freesiagaul/Dalek/Photos/Aaron General/IMG_8128.JPG

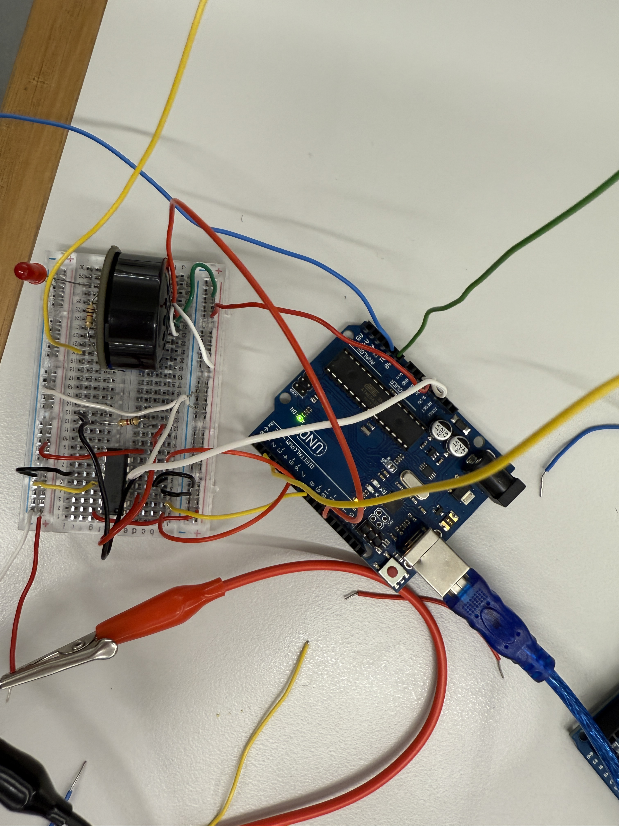
Photos/Aaron General/IMG_8128.JPG
