freesiagaul/Dalek/Photos/Aaron Camera Video/IMG_9345.JPG

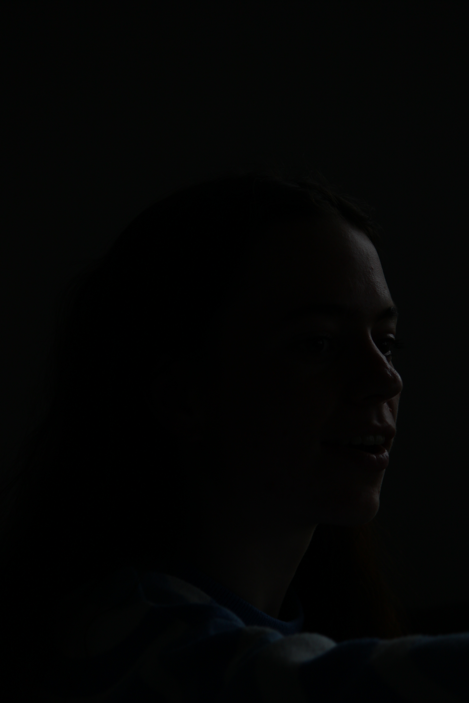
Photos/Aaron Camera Video/IMG_9345.JPG
