freesiagaul/Dalek/Photos/Aaron Camera Video/IMG_9346.JPG

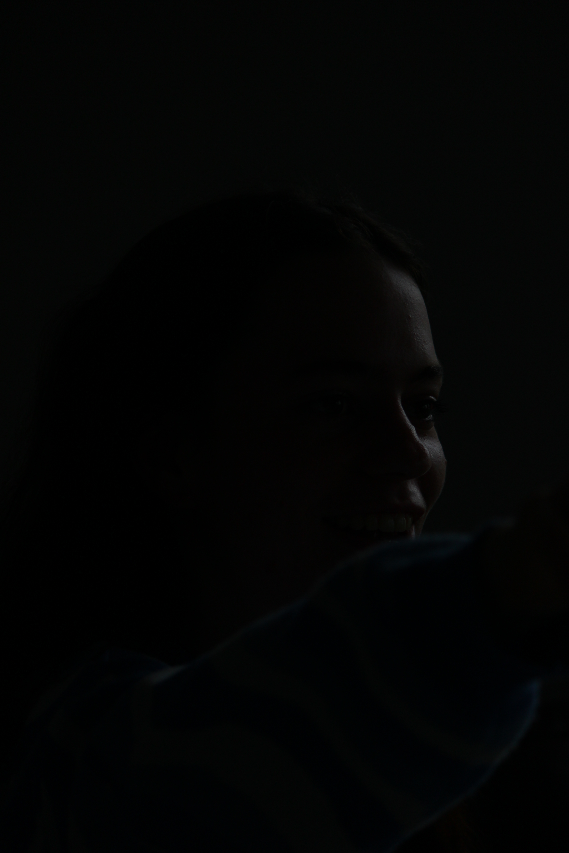
Photos/Aaron Camera Video/IMG_9346.JPG
