freesiagaul/Dalek/Photos/Aaron Camera Video/IMG_9349.JPG

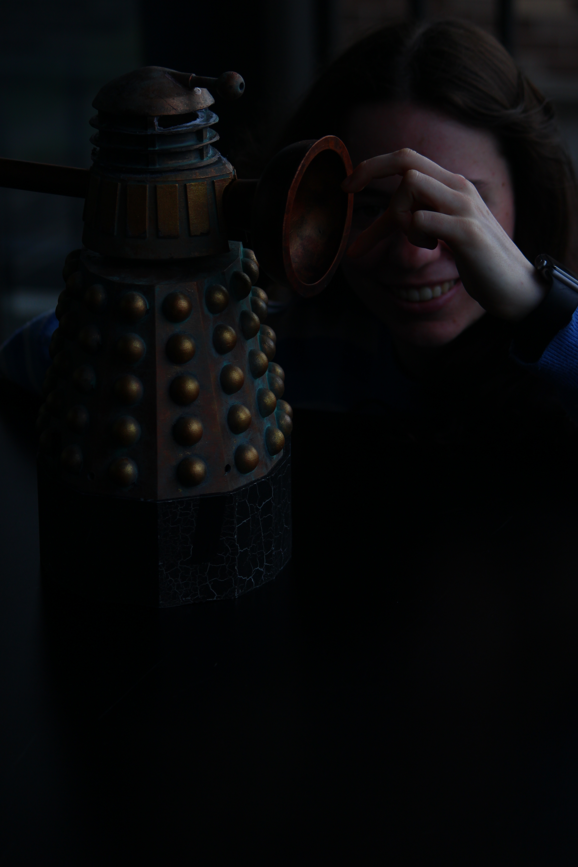
Photos/Aaron Camera Video/IMG_9349.JPG
