freesiagaul/Dalek/Photos/Aaron Camera Video/IMG_9350.JPG

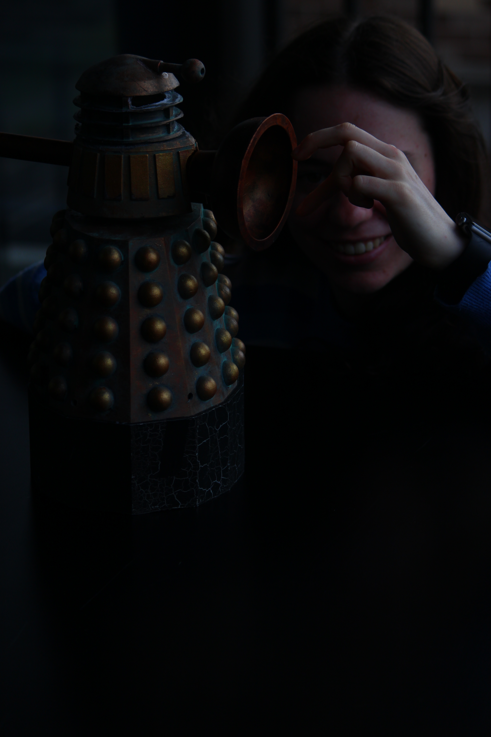
Photos/Aaron Camera Video/IMG_9350.JPG
