freesiagaul/Dalek/Photos/Aaron Camera Video/IMG_9351.JPG

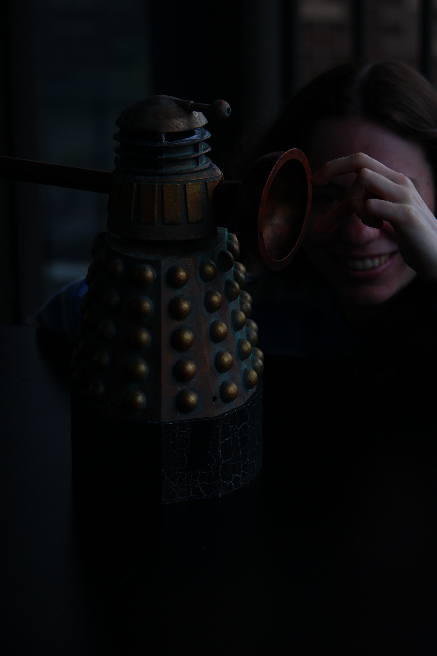
Photos/Aaron Camera Video/IMG_9351.JPG
