freesiagaul/Dalek/Photos/Aaron Camera Video/IMG_9352.JPG

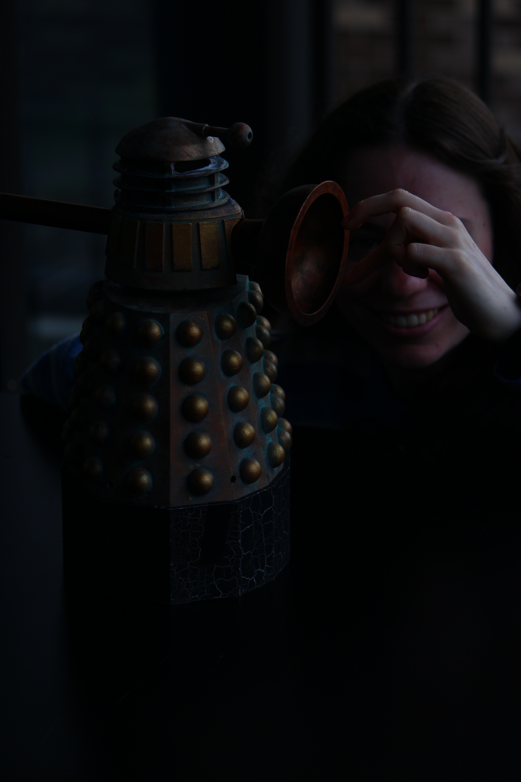
Photos/Aaron Camera Video/IMG_9352.JPG
