freesiagaul/Dalek/Photos/Aaron Camera Video/IMG_9353.JPG

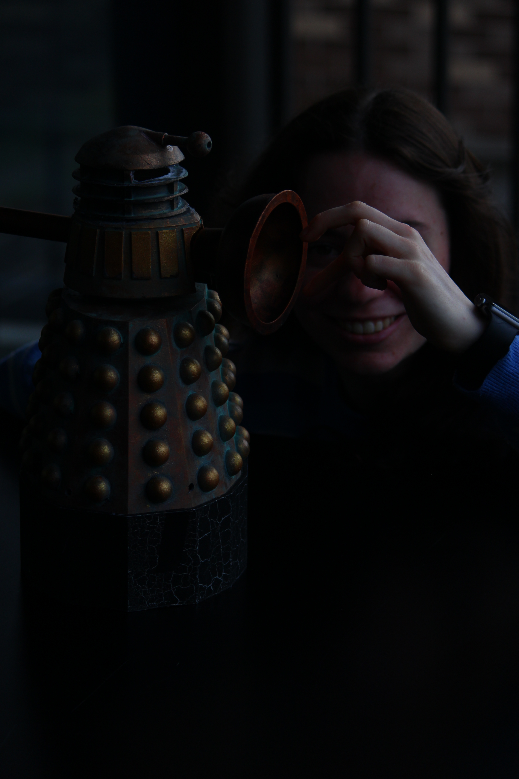
Photos/Aaron Camera Video/IMG_9353.JPG
