freesiagaul/Dalek/Photos/Aaron Camera Video/IMG_9366.JPG

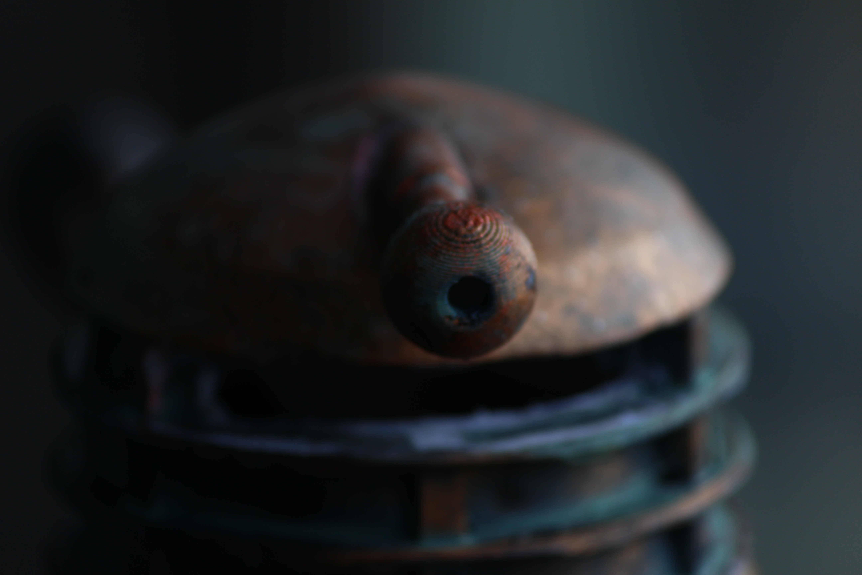
Photos/Aaron Camera Video/IMG_9366.JPG
