freesiagaul/Dalek/Photos/Aaron Camera Video/IMG_9367.JPG

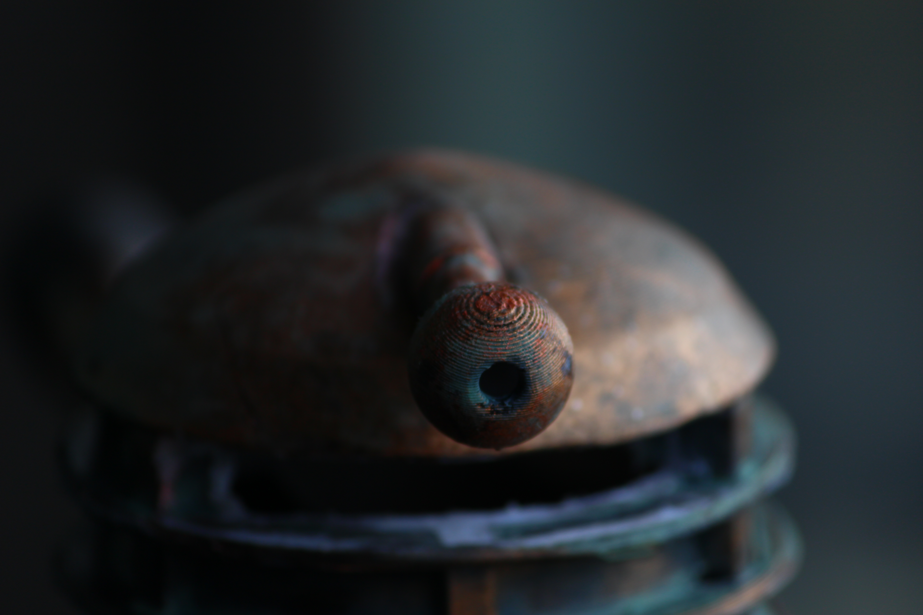
Photos/Aaron Camera Video/IMG_9367.JPG
