freesiagaul/Dalek/Photos/Aaron Camera Video/IMG_9368.JPG

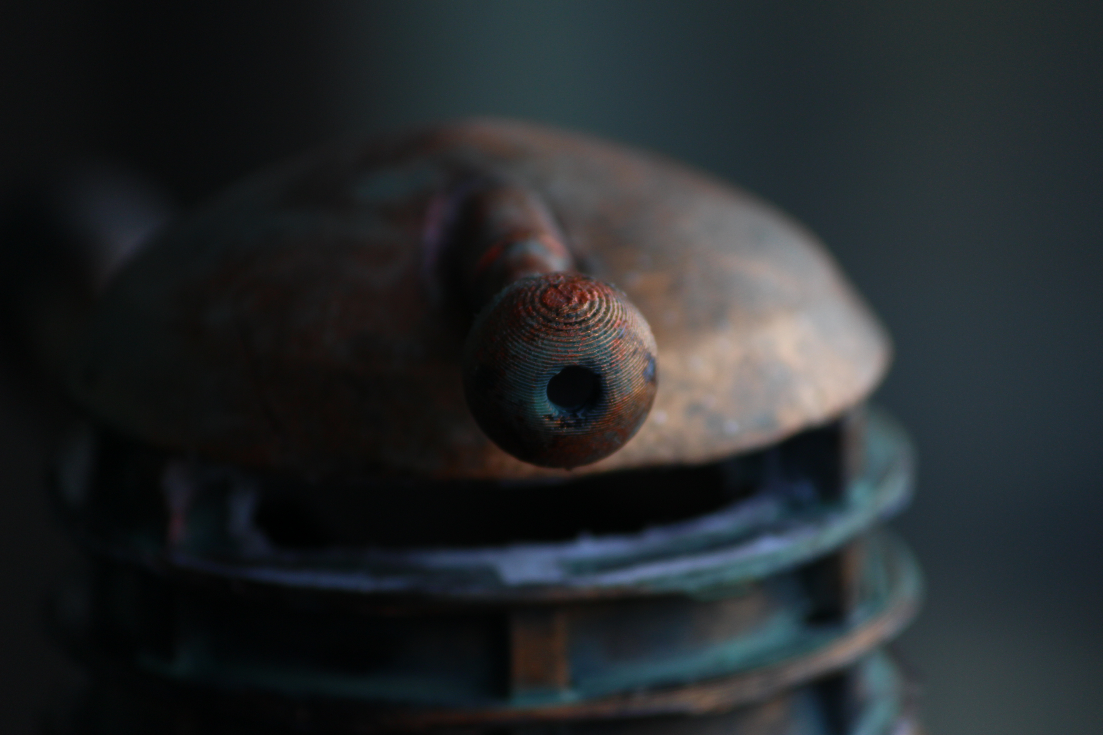
Photos/Aaron Camera Video/IMG_9368.JPG
