freesiagaul/Dalek/Photos/Aaron Camera Video/IMG_9370.JPG

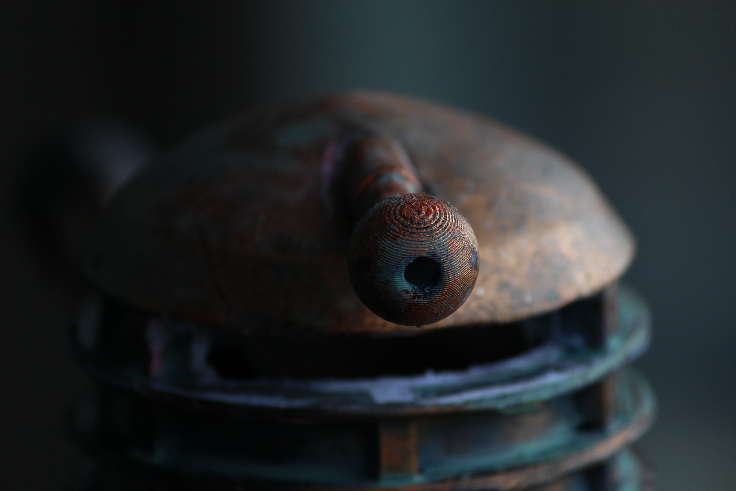
Photos/Aaron Camera Video/IMG_9370.JPG
