freesiagaul/Dalek/Photos/Aaron Camera Video/IMG_9371.JPG

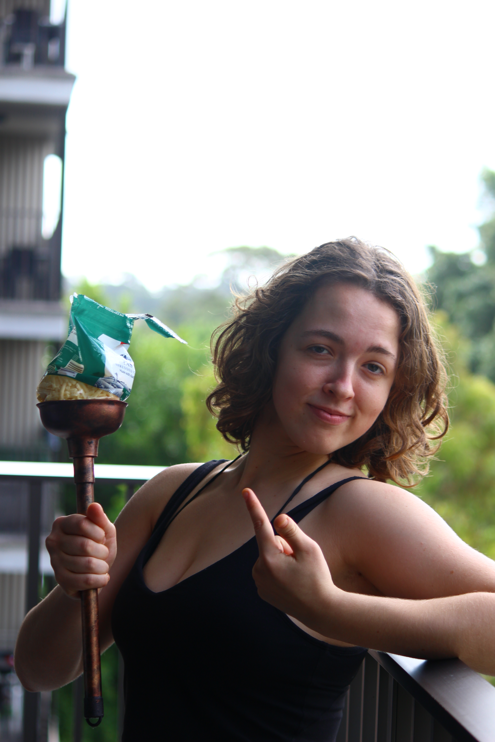
Photos/Aaron Camera Video/IMG_9371.JPG
