freesiagaul/Dalek/Photos/Aaron Camera Video/IMG_9372.JPG

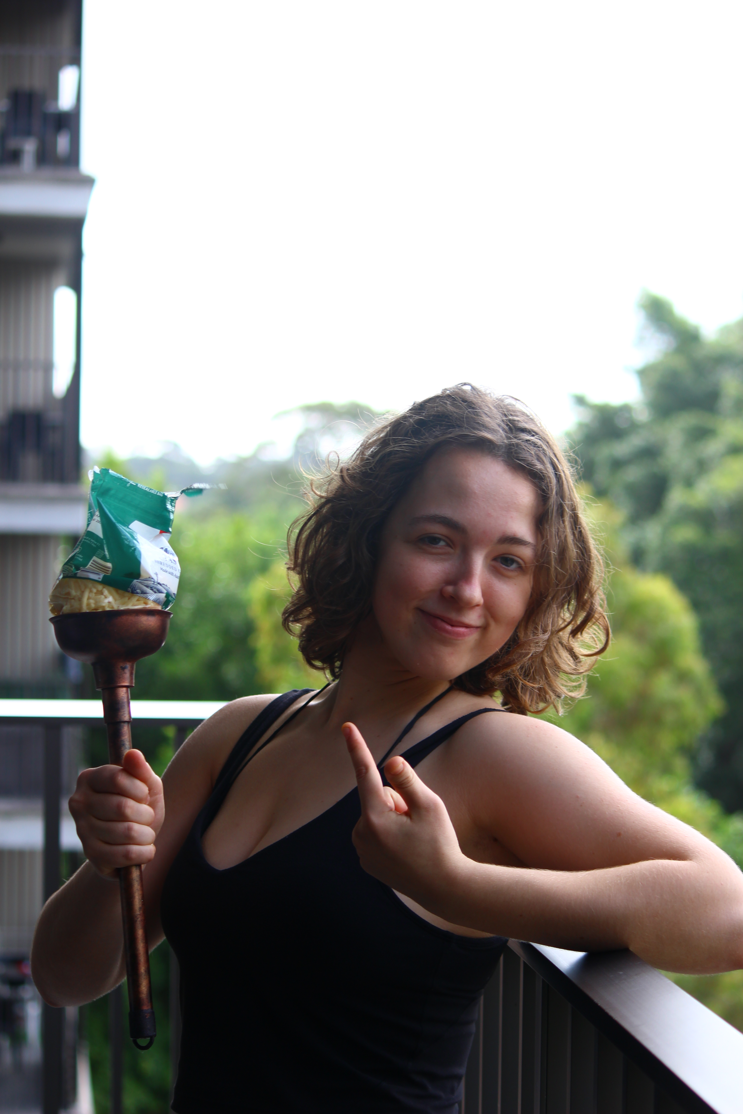
Photos/Aaron Camera Video/IMG_9372.JPG
