freesiagaul/Dalek/Photos/Aaron Camera Video/IMG_9373.JPG

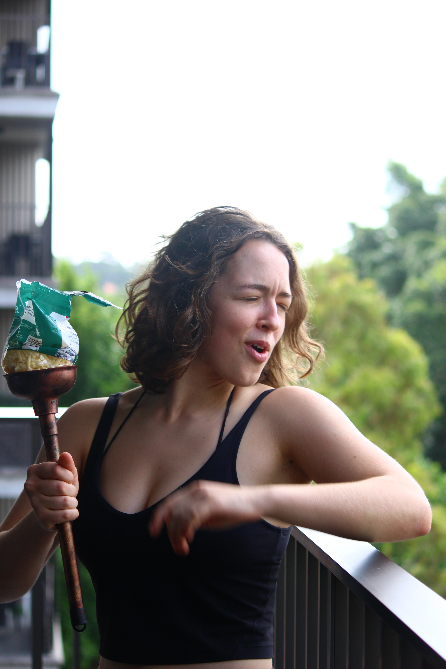
Photos/Aaron Camera Video/IMG_9373.JPG
