freesiagaul/Dalek/Photos/Aaron Camera Video/IMG_9376.JPG

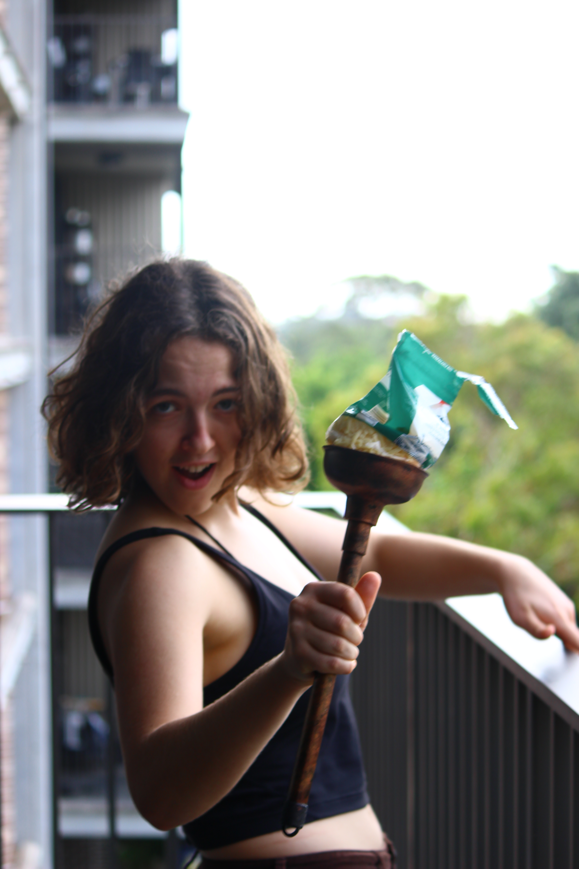
Photos/Aaron Camera Video/IMG_9376.JPG
