freesiagaul/Dalek/Photos/Aaron Camera Video/IMG_9407.JPG

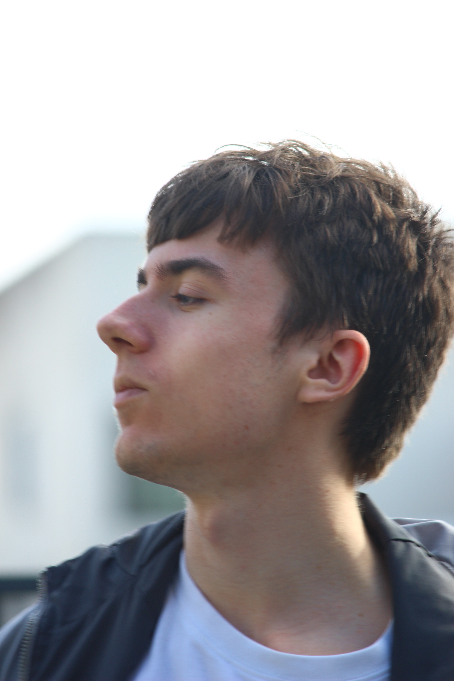
Photos/Aaron Camera Video/IMG_9407.JPG
