freesiagaul/Dalek/Photos/Aaron Camera Video/IMG_9408.JPG

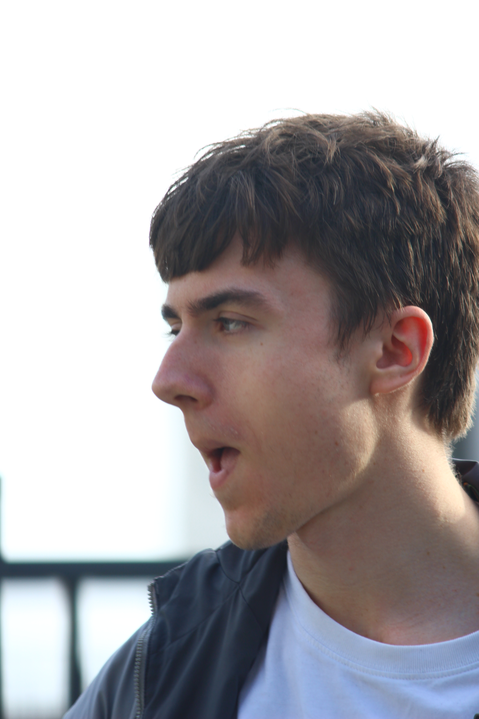
Photos/Aaron Camera Video/IMG_9408.JPG
