freesiagaul/Dalek/Photos/Aaron Camera Video/IMG_9412.JPG

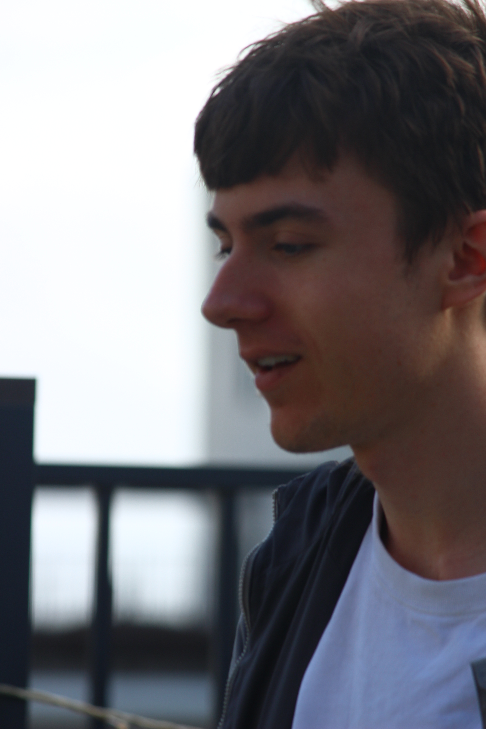
Photos/Aaron Camera Video/IMG_9412.JPG
