freesiagaul/Dalek/Photos/Aaron Camera Video/IMG_9414.JPG

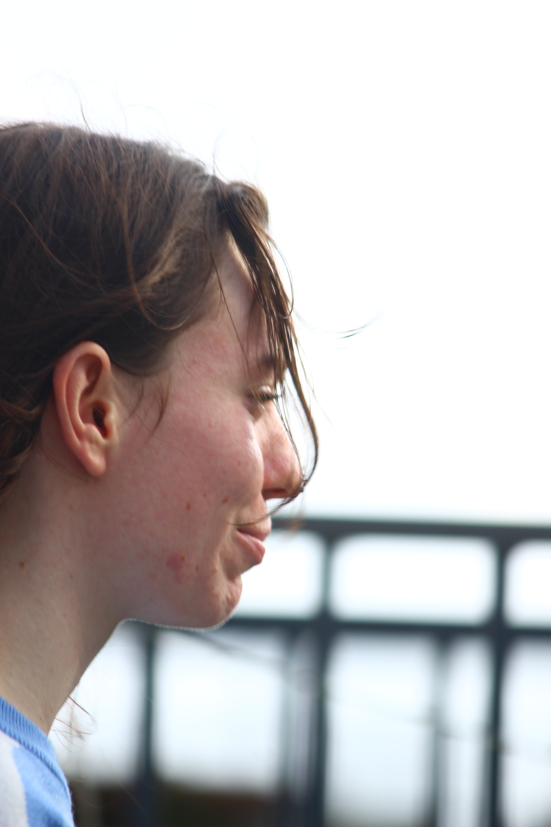
Photos/Aaron Camera Video/IMG_9414.JPG
