freesiagaul/Dalek/Photos/Aaron Camera Video/IMG_9441.JPG

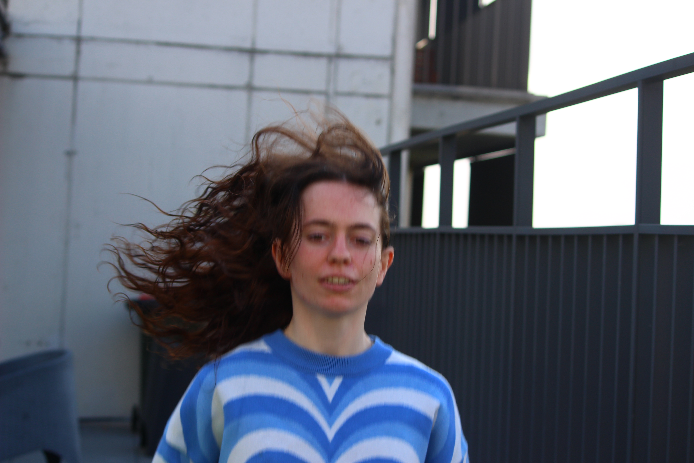
Photos/Aaron Camera Video/IMG_9441.JPG
