freesiagaul/Dalek/Photos/Aaron Camera Video/IMG_9444.JPG

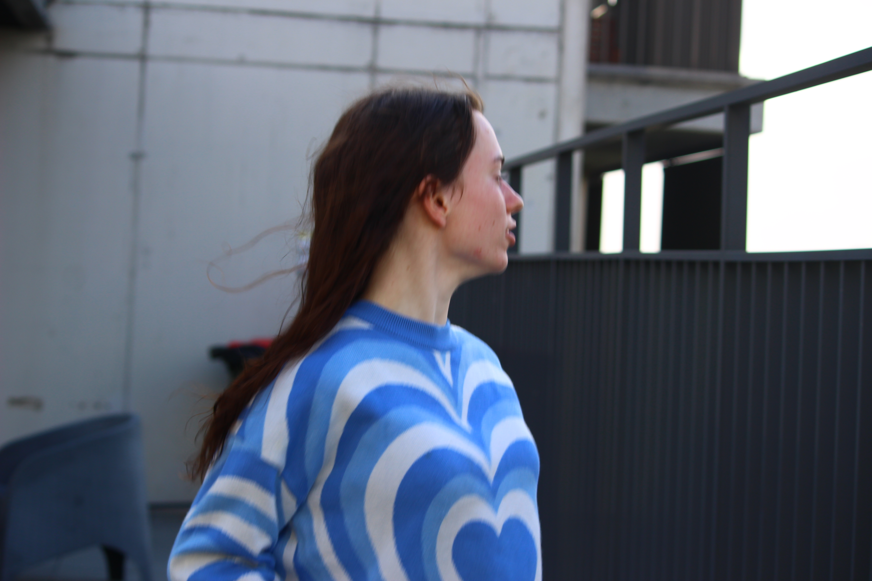
Photos/Aaron Camera Video/IMG_9444.JPG
