freesiagaul/Dalek/Photos/Aaron Camera Video/IMG_9469.JPG

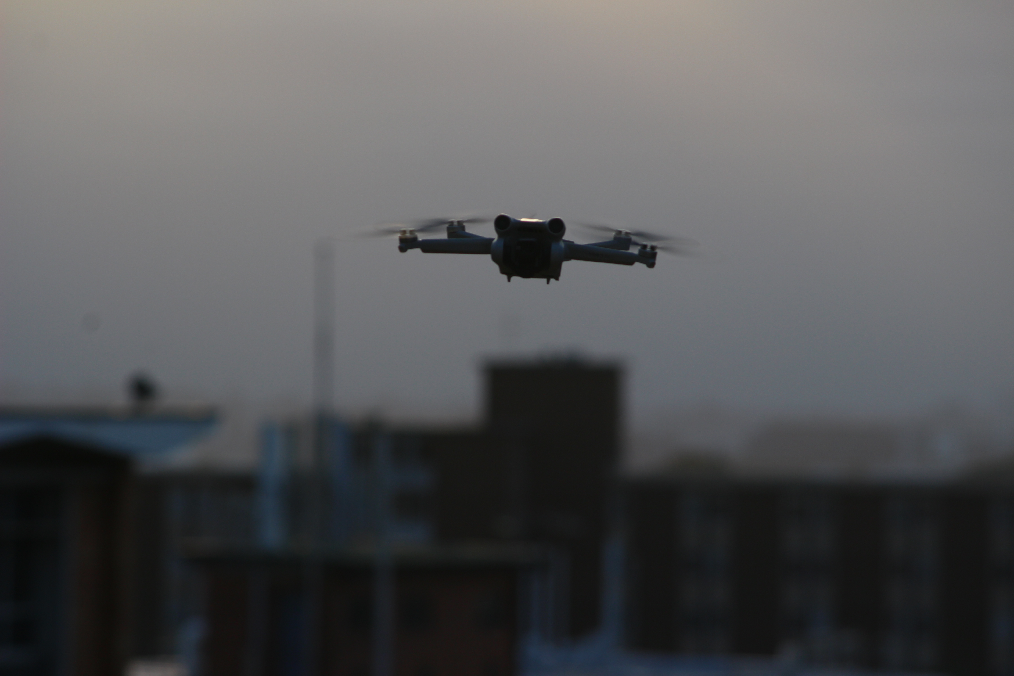
Photos/Aaron Camera Video/IMG_9469.JPG
