freesiagaul/Dalek/Photos/Aaron Camera Video/IMG_9470.JPG

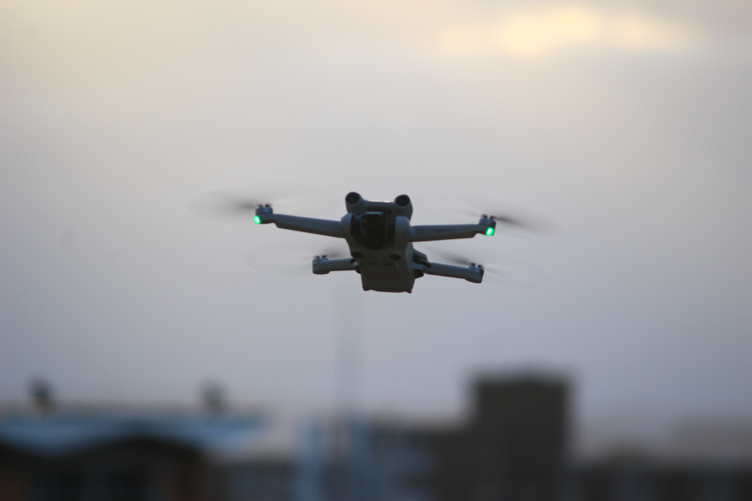
Photos/Aaron Camera Video/IMG_9470.JPG
