freesiagaul/Dalek/Photos/Aaron Camera Video/IMG_9471.JPG

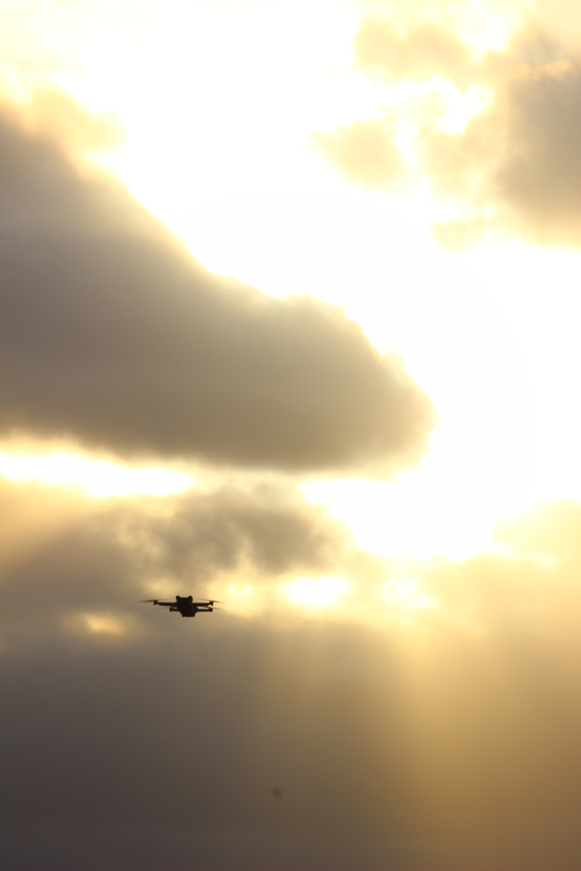
Photos/Aaron Camera Video/IMG_9471.JPG
