freesiagaul/Dalek/Photos/Aaron Camera Video/IMG_9472.JPG

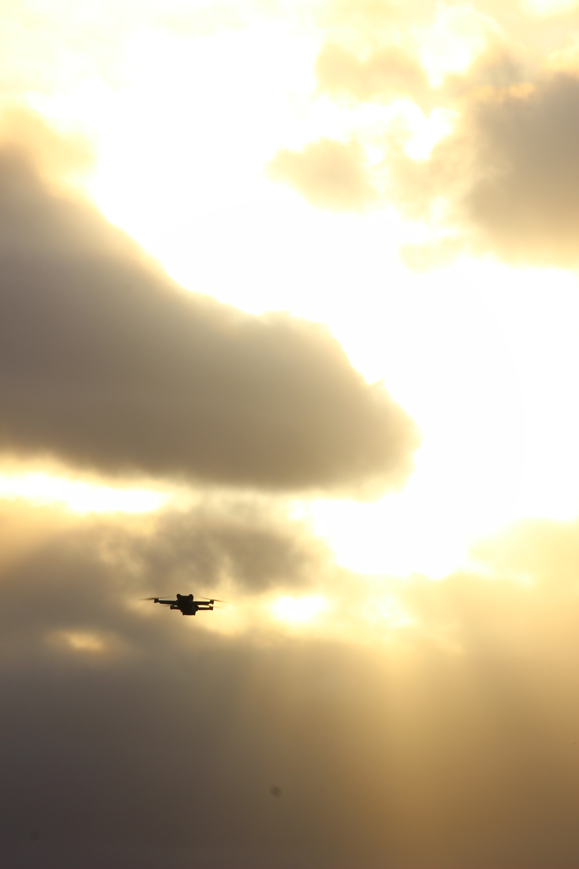
Photos/Aaron Camera Video/IMG_9472.JPG
