freesiagaul/Dalek/Photos/Aaron Camera Video/IMG_9473.JPG

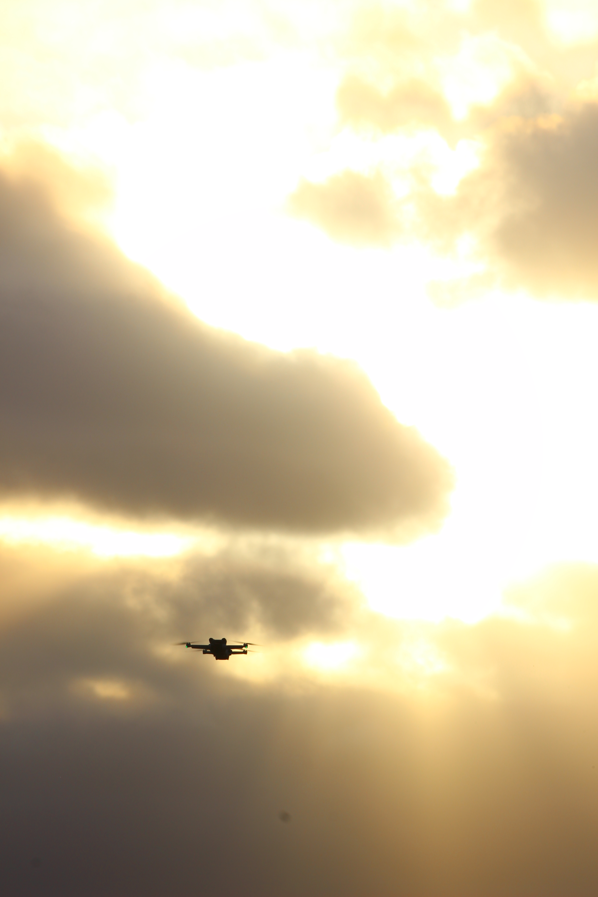
Photos/Aaron Camera Video/IMG_9473.JPG
