freesiagaul/Dalek/Photos/Aaron Camera Video/IMG_9474.JPG

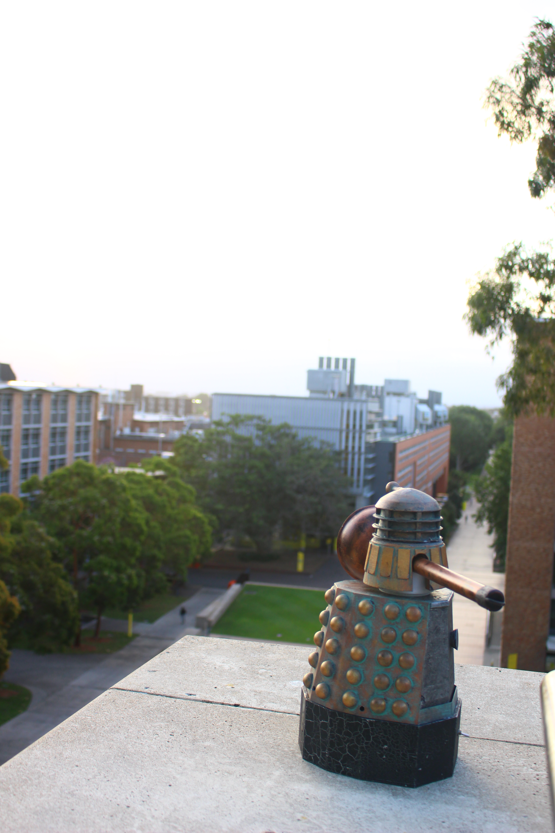
Photos/Aaron Camera Video/IMG_9474.JPG
