freesiagaul/Dalek/Photos/Aaron Camera Video/IMG_9475.JPG

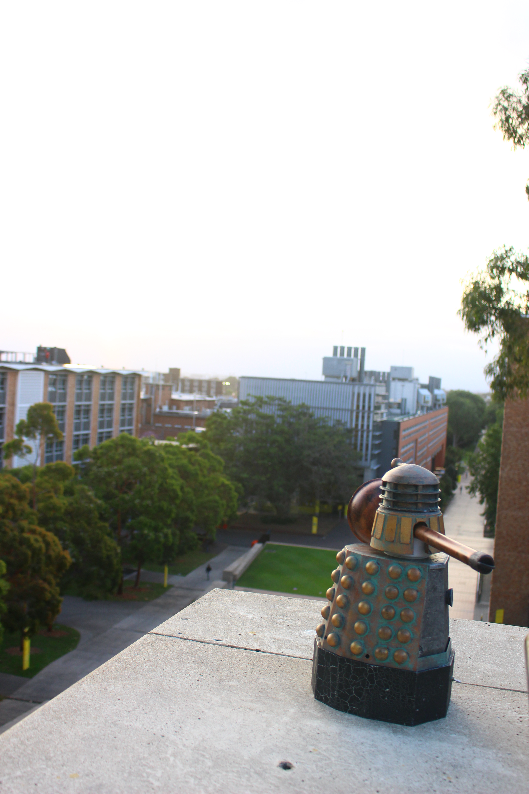
Photos/Aaron Camera Video/IMG_9475.JPG
