freesiagaul/Dalek/Photos/Aaron Camera Video/IMG_9476.JPG

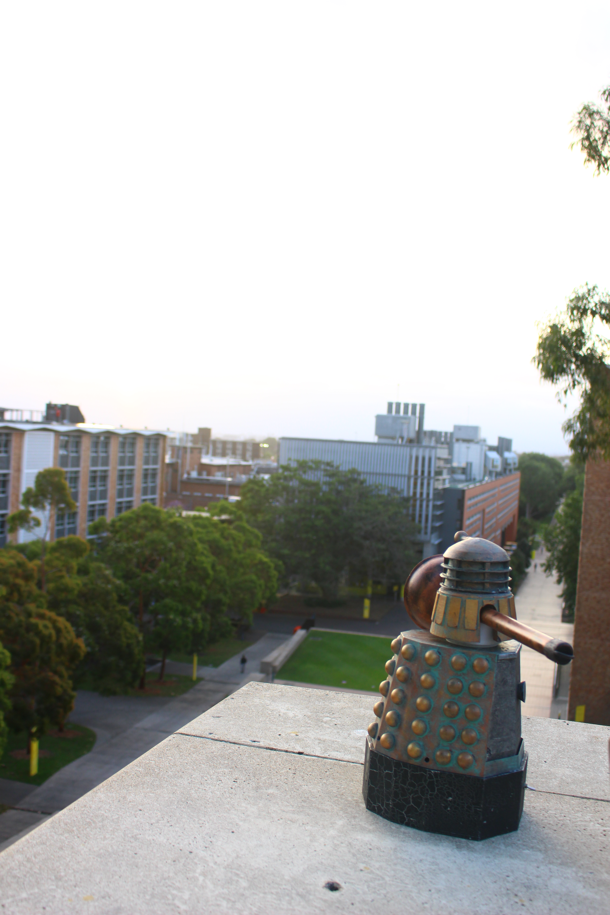
Photos/Aaron Camera Video/IMG_9476.JPG
