freesiagaul/Dalek/Photos/Aaron Camera Video/IMG_9477.JPG

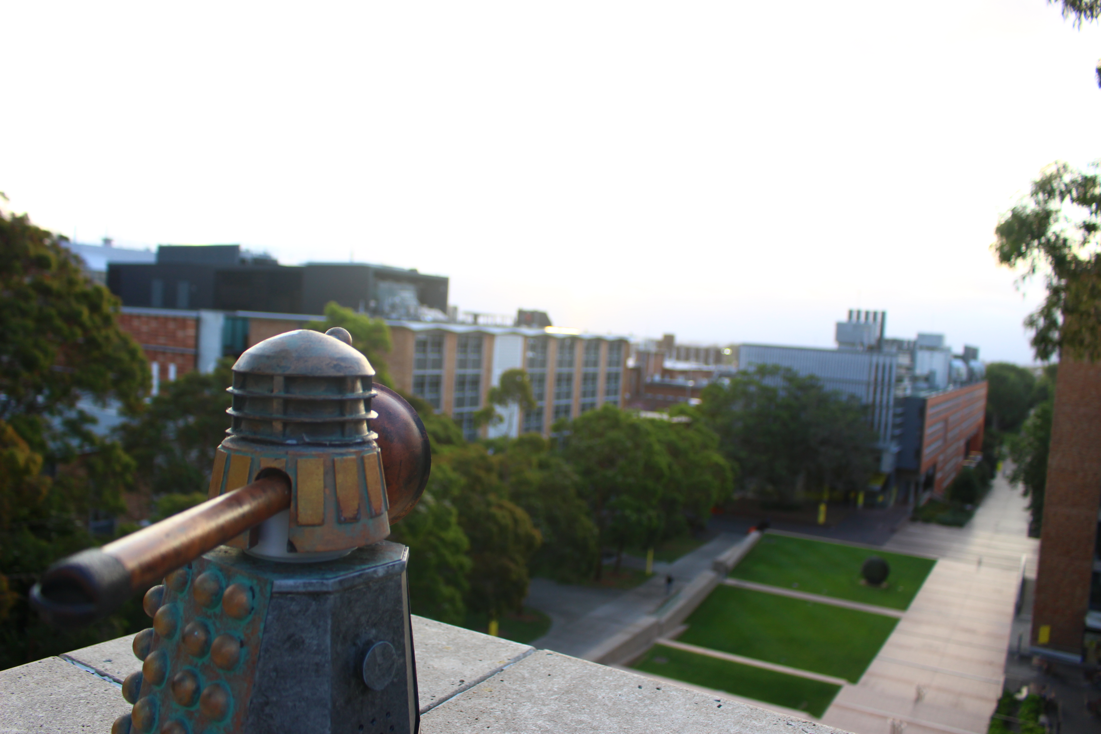
Photos/Aaron Camera Video/IMG_9477.JPG
