freesiagaul/Dalek/Photos/Aaron Camera Video/IMG_9478.JPG

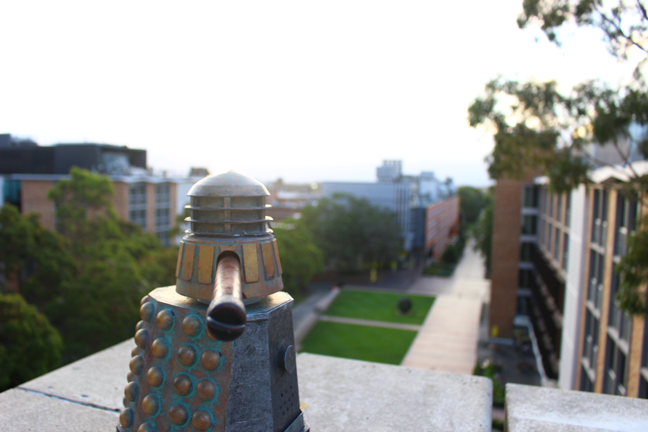
Photos/Aaron Camera Video/IMG_9478.JPG
