freesiagaul/Dalek/Photos/Aaron Camera Video/IMG_9479.JPG

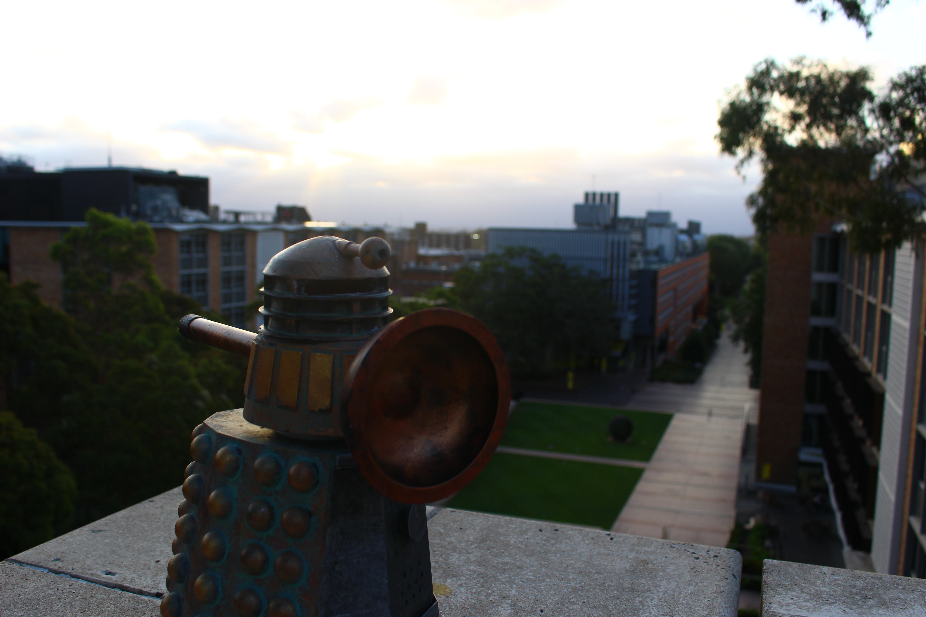
Photos/Aaron Camera Video/IMG_9479.JPG
