freesiagaul/Dalek/Photos/Aaron Camera Video/IMG_9481.JPG

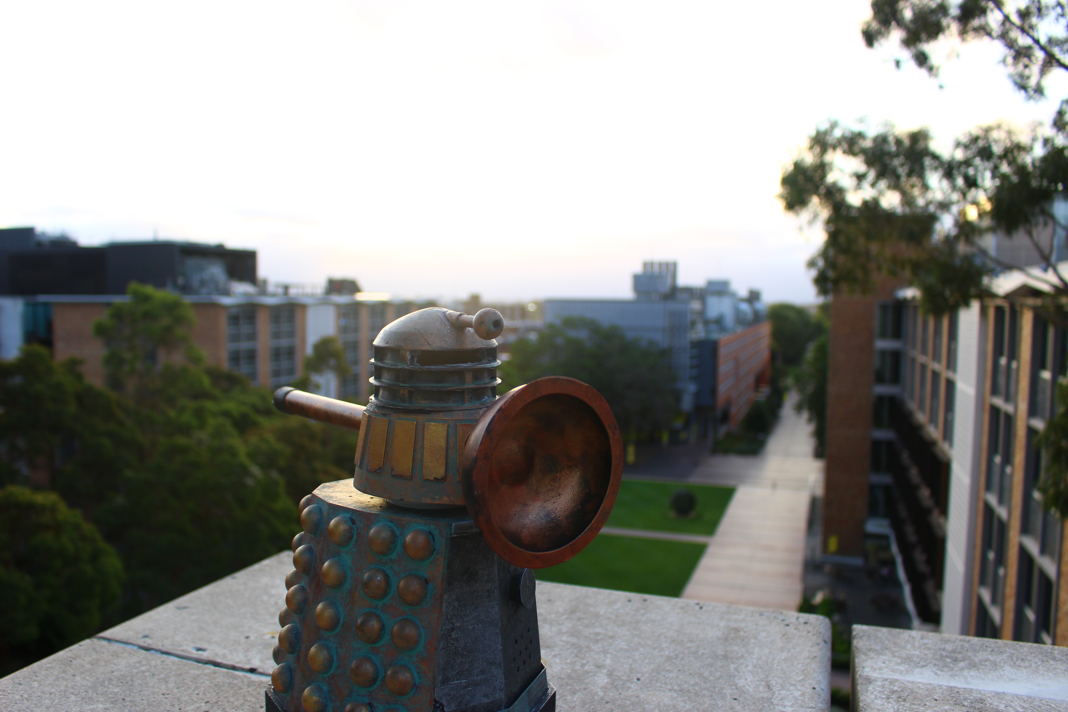
Photos/Aaron Camera Video/IMG_9481.JPG
