freesiagaul/Dalek/Photos/Aaron Camera Video/IMG_9482.JPG

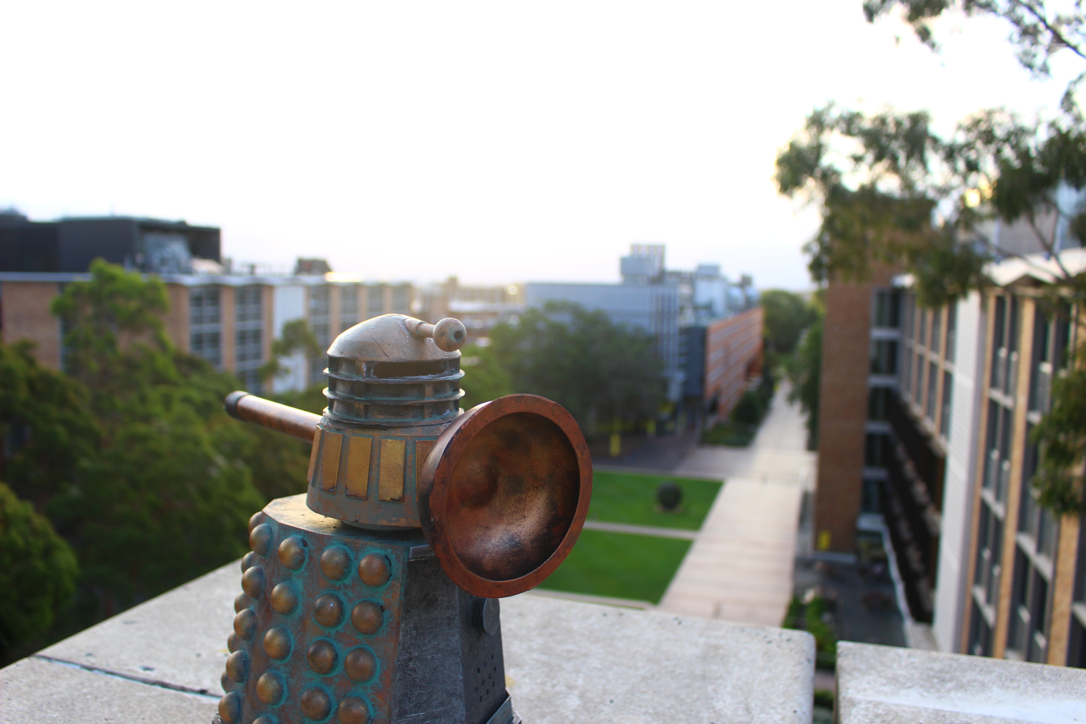
Photos/Aaron Camera Video/IMG_9482.JPG
