freesiagaul/Dalek/Photos/Aaron Camera Video/IMG_9494.JPG

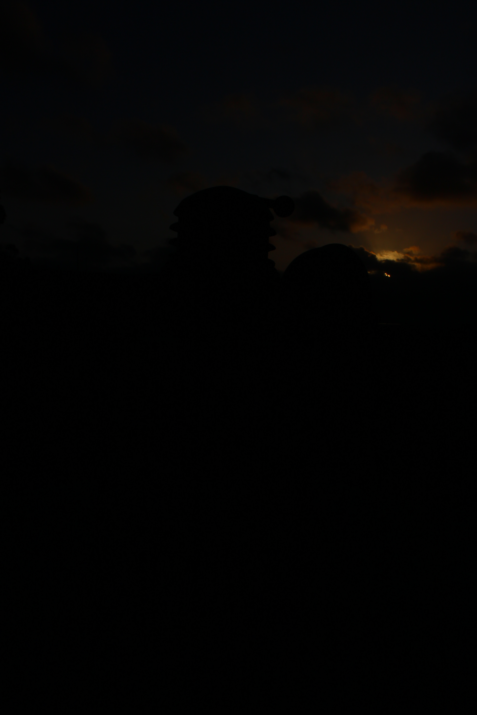
Photos/Aaron Camera Video/IMG_9494.JPG
