freesiagaul/Dalek/Photos/Aaron Camera Video/IMG_9495.JPG

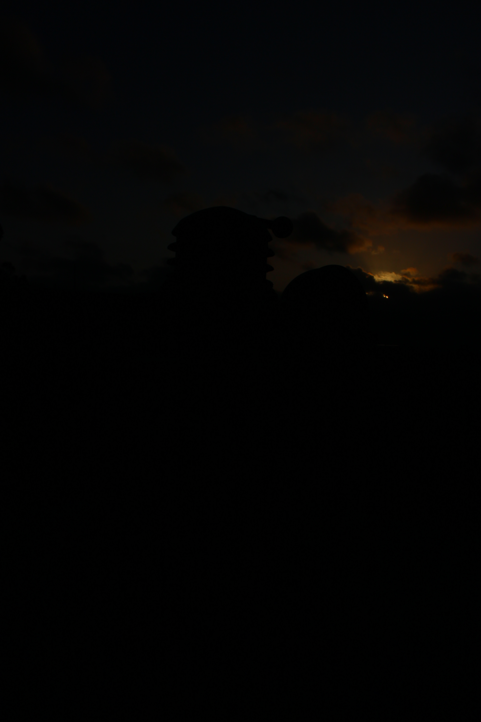
Photos/Aaron Camera Video/IMG_9495.JPG
