freesiagaul/Dalek/Photos/Aaron Camera Video/IMG_9496.JPG

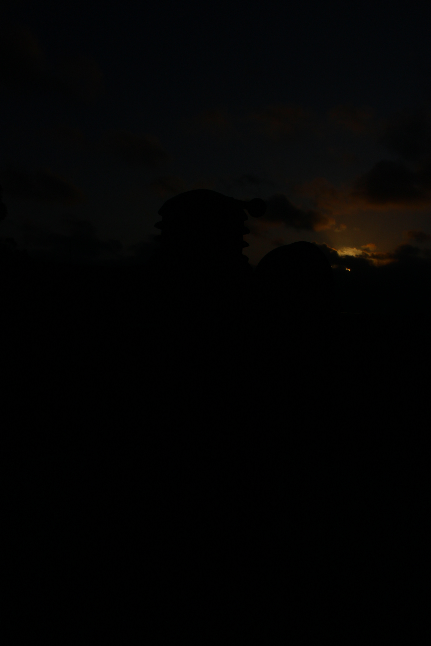
Photos/Aaron Camera Video/IMG_9496.JPG
