freesiagaul/Dalek/Photos/Aaron General/2DB27E6C-DF62-459F-9CFB-9964522434A4.JPG

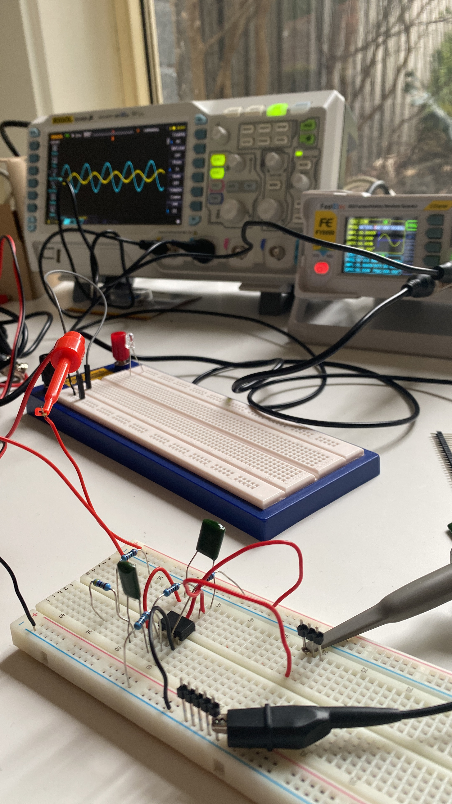
Photos/Aaron General/2DB27E6C-DF62-459F-9CFB-9964522434A4.JPG
