freesiagaul/Dalek/Photos/Aaron General/88AF48DE-36DF-4783-B3CE-C7E6D223535E.JPG

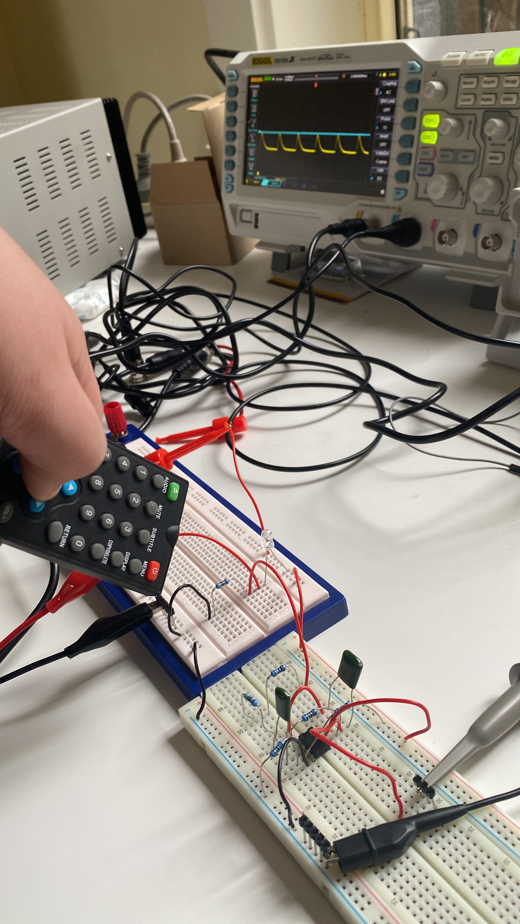
Photos/Aaron General/88AF48DE-36DF-4783-B3CE-C7E6D223535E.JPG
