freesiagaul/Dalek/Photos/Aaron General/Acceptence_Sensor.jpg

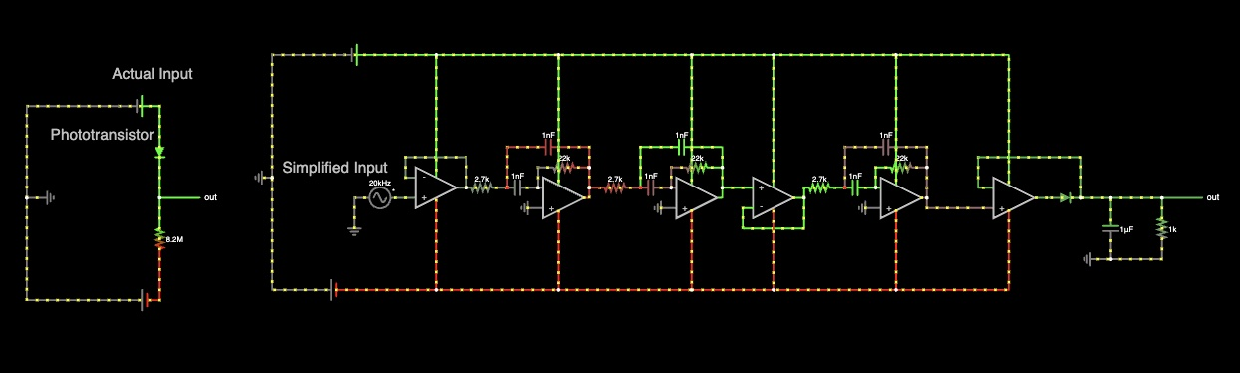
Photos/Aaron General/Acceptence_Sensor.jpg
