freesiagaul/Dalek/Photos/Aaron General/Active_Band_Pass_filter_V1.jpg

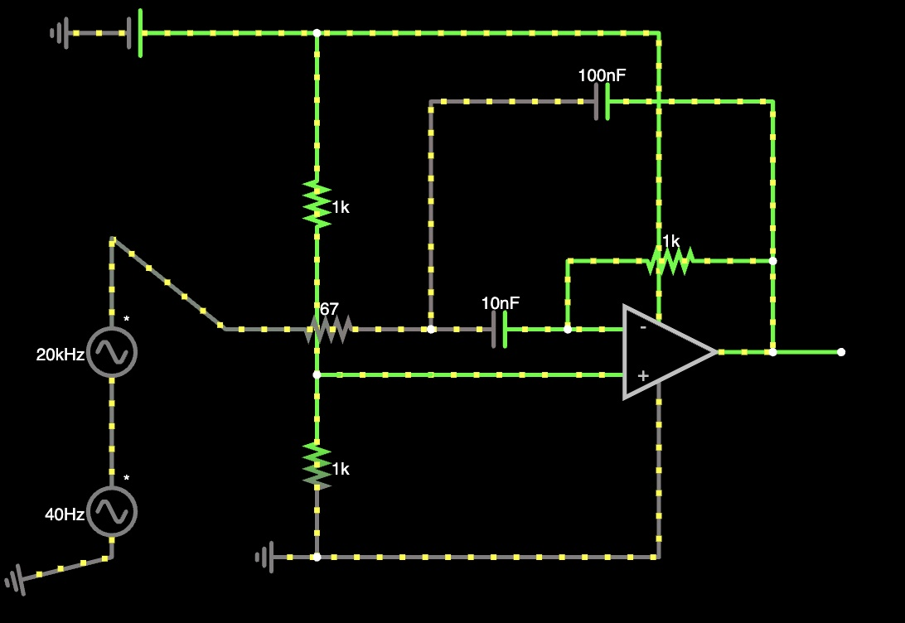
Photos/Aaron General/Active_Band_Pass_filter_V1.jpg
