freesiagaul/Dalek/Photos/Aaron General/IMG_4114.JPG

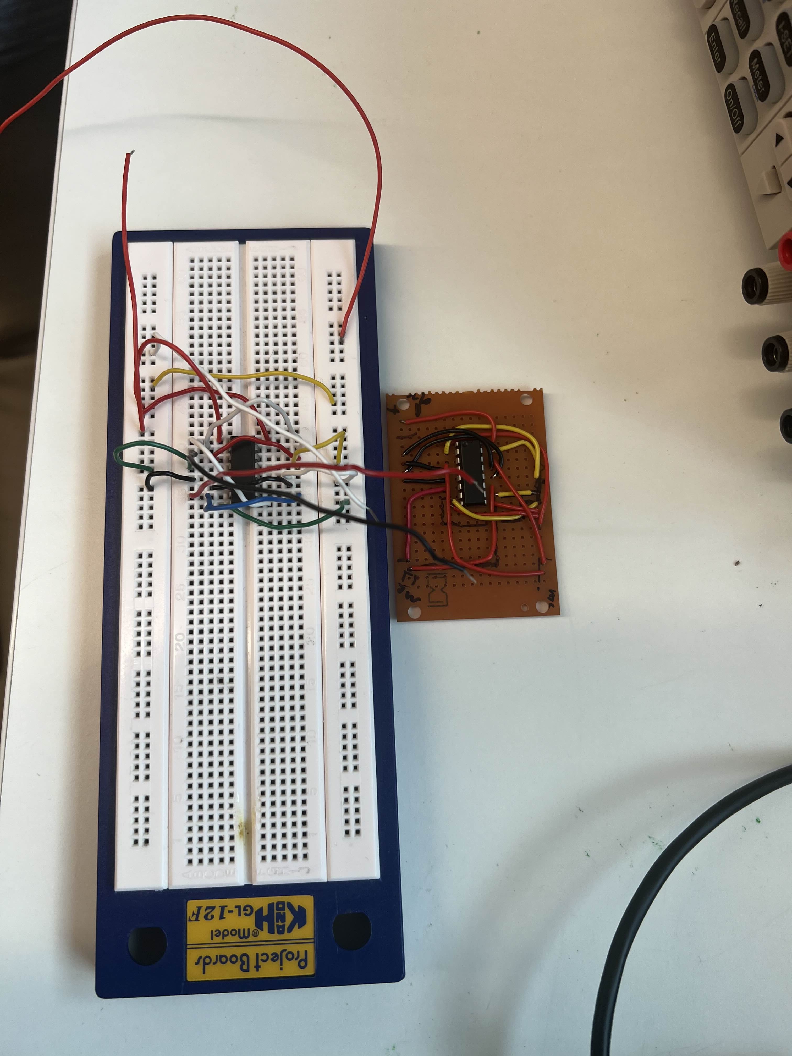
Photos/Aaron General/IMG_4114.JPG
