freesiagaul/Dalek/Photos/Aaron General/IMG_8074.JPG

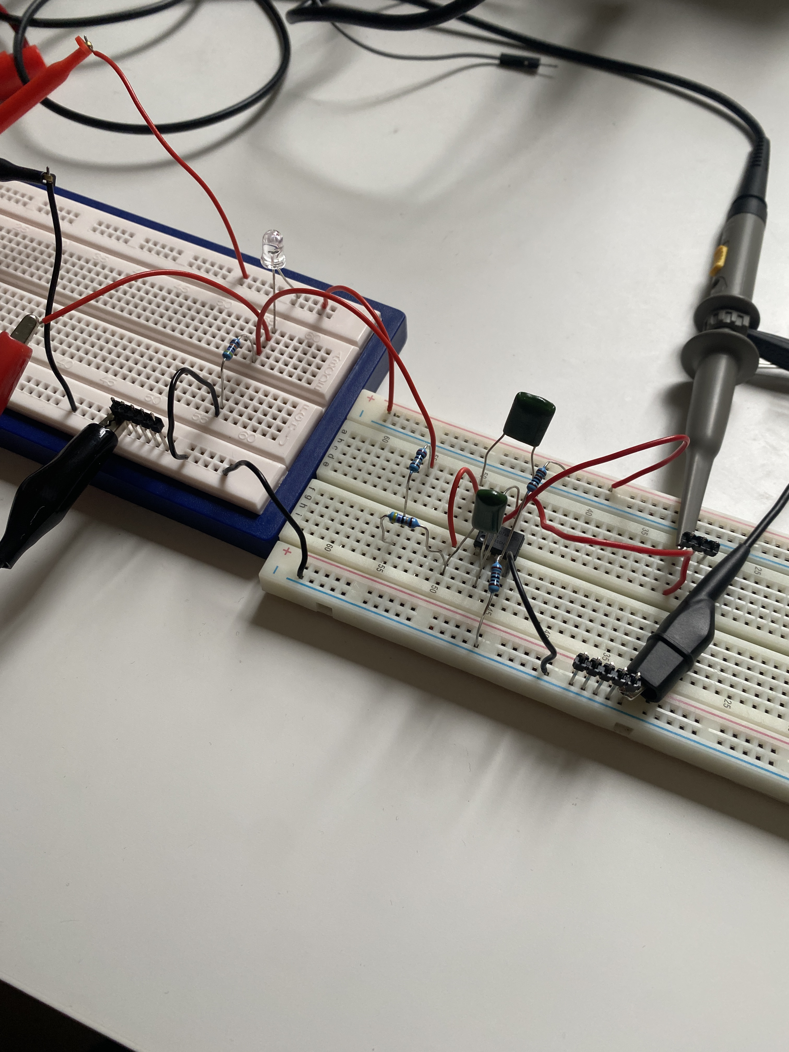
Photos/Aaron General/IMG_8074.JPG
