freesiagaul/Dalek/Photos/Aaron General/IMG_8075.JPG

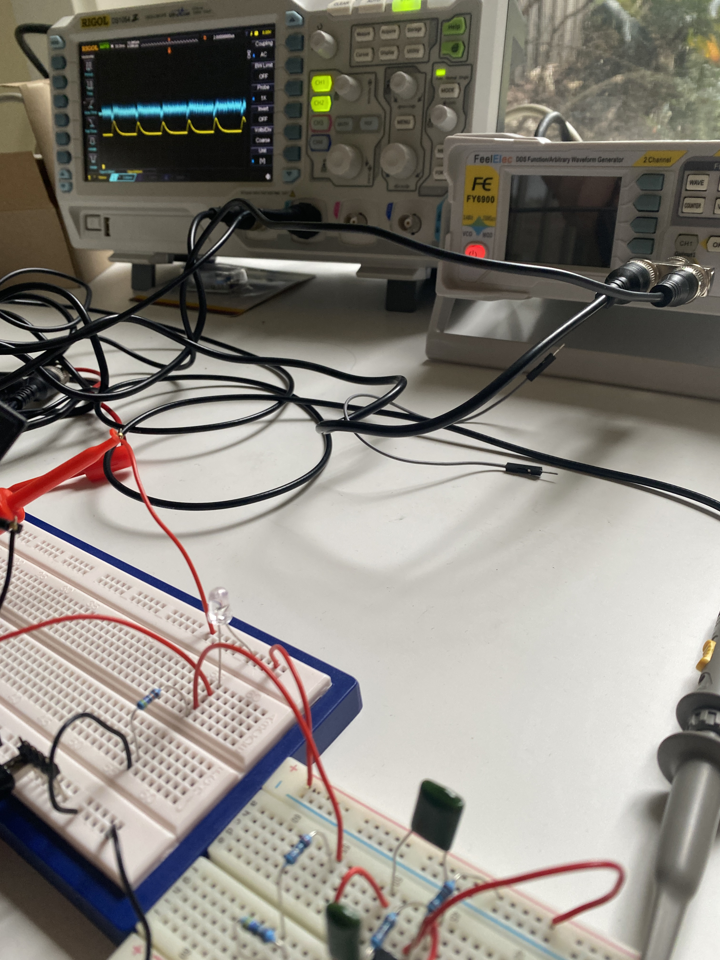
Photos/Aaron General/IMG_8075.JPG
