freesiagaul/Dalek/Photos/Aaron General/IMG_8127.JPG

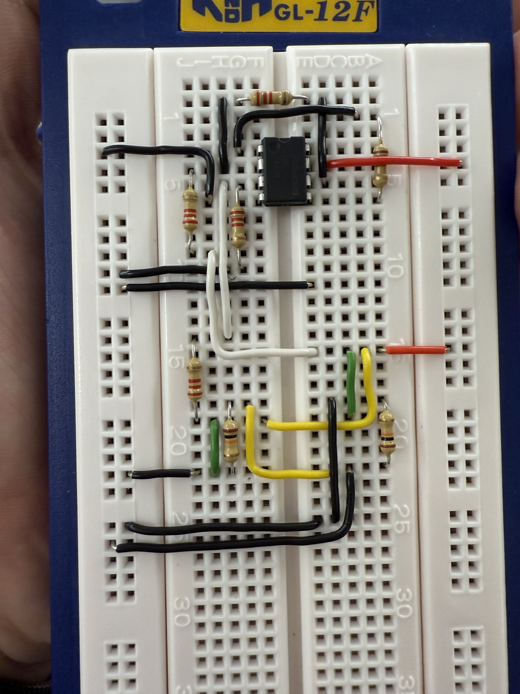
Photos/Aaron General/IMG_8127.JPG
