freesiagaul/Dalek/Photos/Aaron General/IMG_8300.JPG

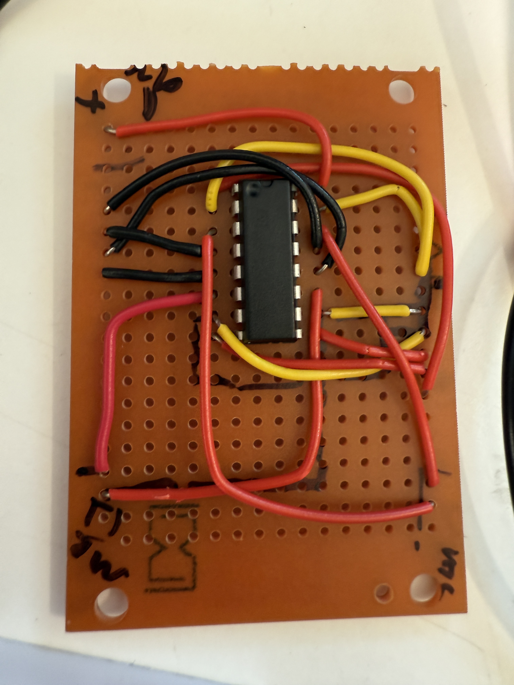
Photos/Aaron General/IMG_8300.JPG
