freesiagaul/Dalek/Photos/Aaron General/Peak Detector.jpg

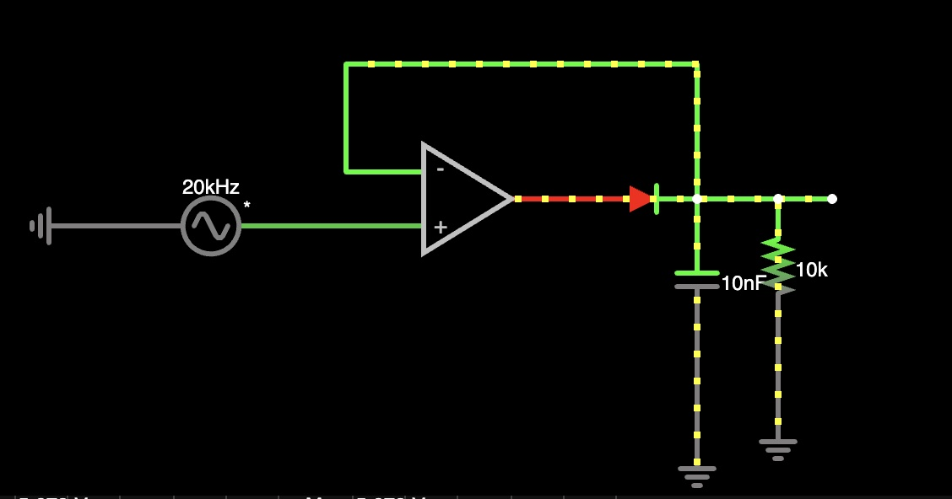
Photos/Aaron General/Peak Detector.jpg
