freesiagaul/Dalek/Photos/Aaron General/Possible_High_Pass_Filter.jpg

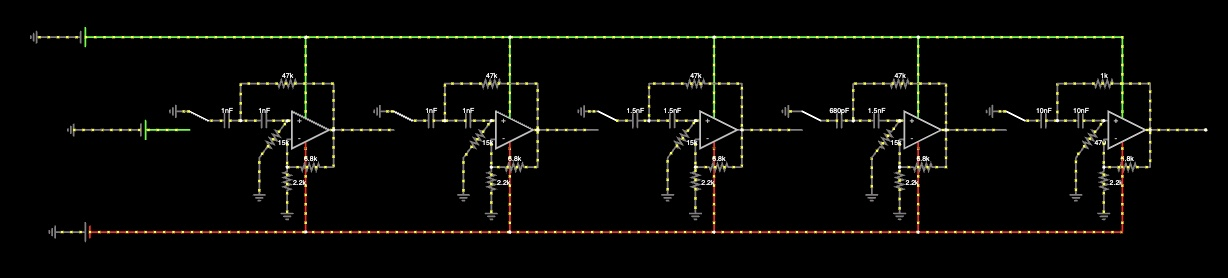
Photos/Aaron General/Possible_High_Pass_Filter.jpg
