freesiagaul/Dalek/Photos/Aaron General/Possible_High_Pass_Filter_Ideal.jpg

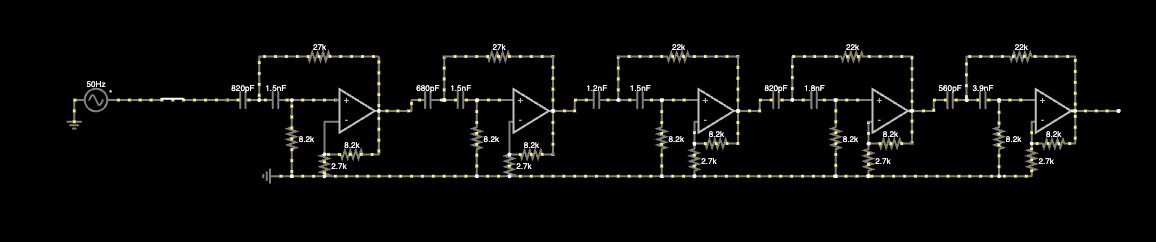
Photos/Aaron General/Possible_High_Pass_Filter_Ideal.jpg
