freesiagaul/Dalek/Photos/Aaron General/Voltage Diagram.jpg

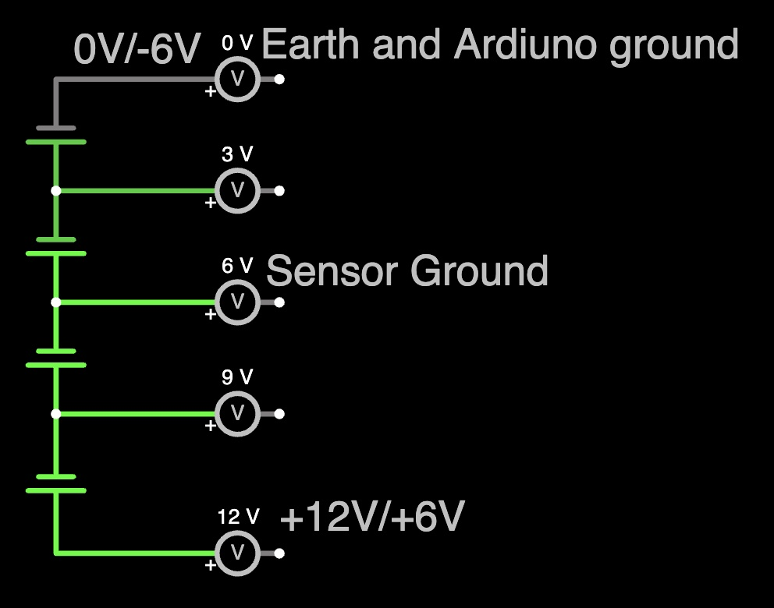
Photos/Aaron General/Voltage Diagram.jpg
