freesiagaul/Dalek/(list of files, cad)

Other CAD files:
Dalek.stl
Dalek(Old).stl
