freesiagaul/Dalek/Freesia journals/5.pdf

# Week 5

## Goal

The signals group is working on filtering and changing AC over to DC this week.

### Personal Tasks

The team has made another Gannt chart, due to being busy over midterms Aaron is helping manage work. Currently I am working on sensing, setting off the LED's and communicating with the "EXTERMINATE" terminal.

This is shown in the Gannt chart below:

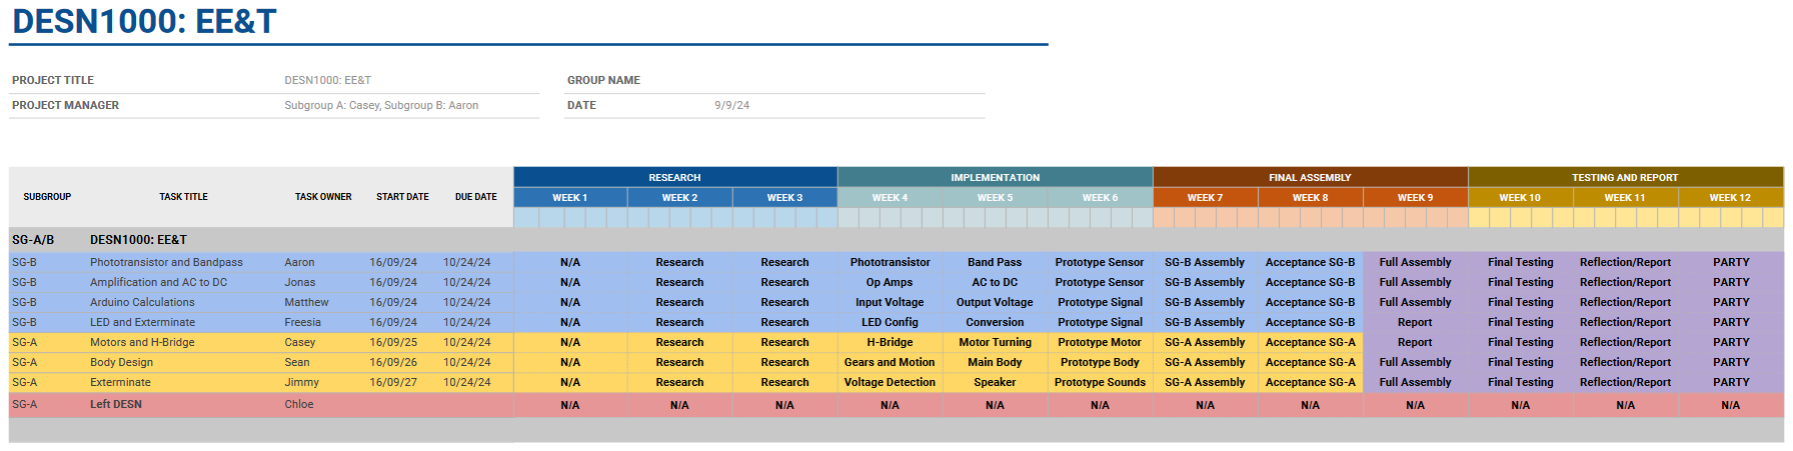
[picture p95: figure]

So far, the sensing and LED's are going off, but the +-10 degree LED will need to happen once the voltages have been converted and compared. Hence now I am trying to convert the AC signals into something which can be subtracted through an Op-Amp. I have made a prototype of the sensor for the left side which sets off an LED. "LED left" is symmetrical with "LED right," and I am planning on moving it onto a veroboard.

From here, I am going to try to convert the AC signal post-filter and amplification such that the signals going in will be compared so that "LED middle" sets off for +-10 degrees of the emitter. I am considering methods to stabilise the voltage for comparison currently. Once I can do the math to determine if the emitter is in +-10 degrees, then I can work on completing the "EXTERMINATE" communication wire.

The outline of what is going to be sized down next to the filter is shown below:

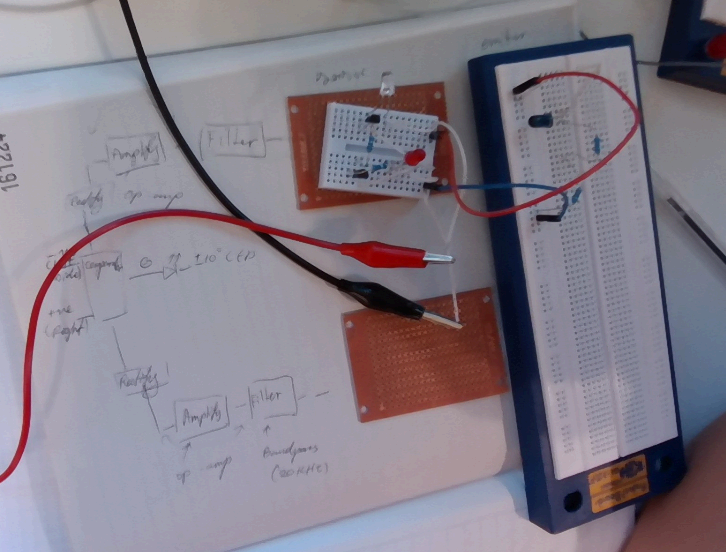
[picture p96: figure]

### Challenges

Challenges going forward mostly surround organising my time effectively. I have a very busy life outside of university and need to know how to prioritise tasks in terms of time efficiency better.

Outside of this, I am still thinking the comparator and its communication to the motors team is where the group is going to face the biggest challenges.

Week 6 is flexi-week, meaning that we will have less access to testing resources. This will present a challenge.
