freesiagaul/Dalek/(commit log)

2024-11-23 add stl
2024-12-01 Rename Dalek (2).stl to Dalek
2024-12-01 Update and rename Dalek to Dalek.stl
    [Dalek.stl]
2024-12-01 Rename Dalek (2).stl to Dalek.stl
    [Dalek.stl]
