freesiagaul/Dalek/(notices)

Notices in the files:
README.md:
License: MIT
