freesiagaul/Dalek/Photos/Aaron Camera Video/IMG_9347.JPG

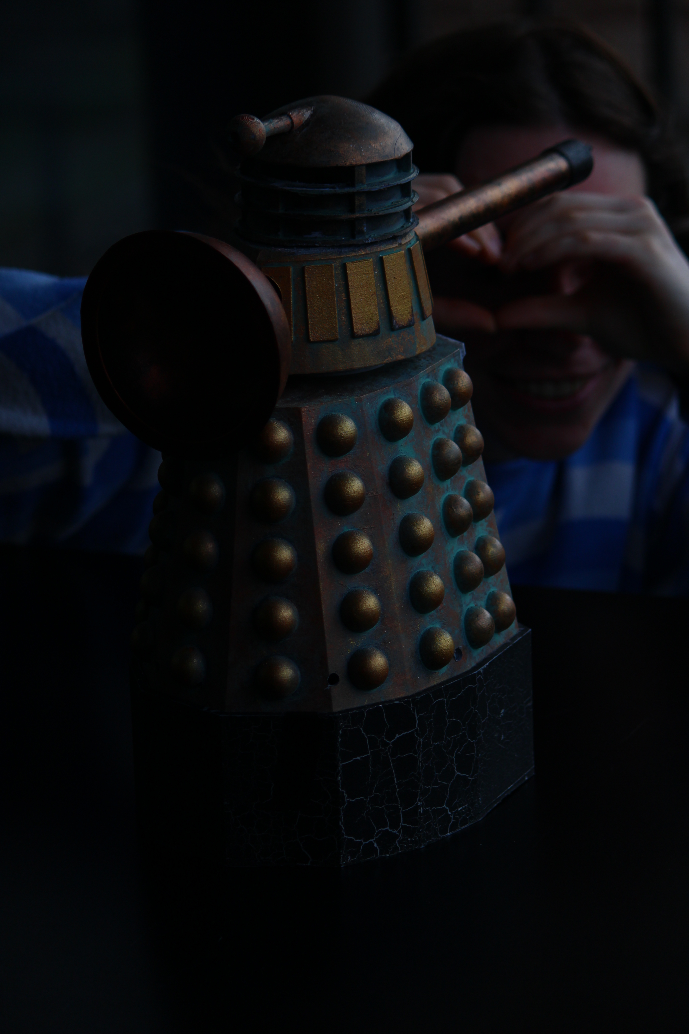
Photos/Aaron Camera Video/IMG_9347.JPG
