freesiagaul/Dalek/Photos/Aaron Camera Video/IMG_9348.JPG

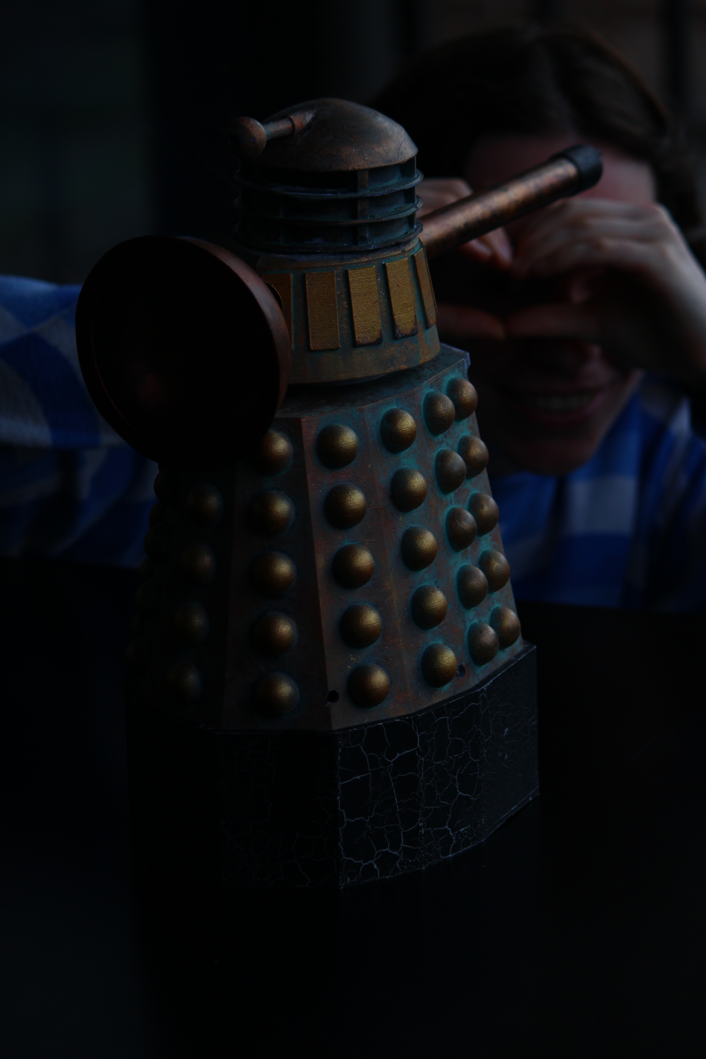
Photos/Aaron Camera Video/IMG_9348.JPG
