freesiagaul/Dalek/Photos/Aaron Camera Video/IMG_9357.JPG

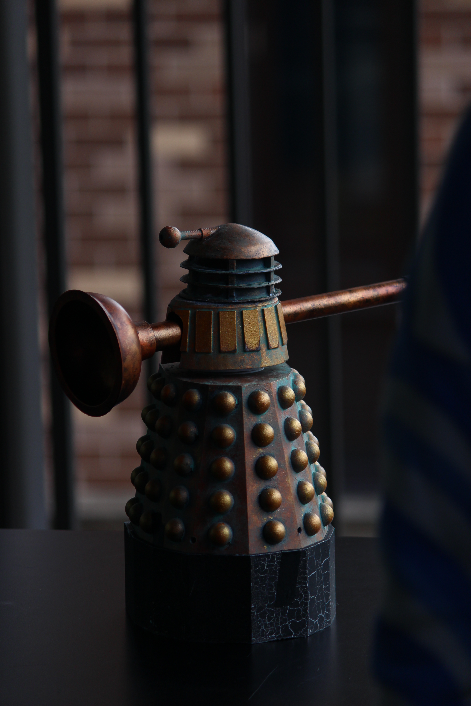
Photos/Aaron Camera Video/IMG_9357.JPG
