freesiagaul/Dalek/Photos/Aaron Camera Video/IMG_9374.JPG

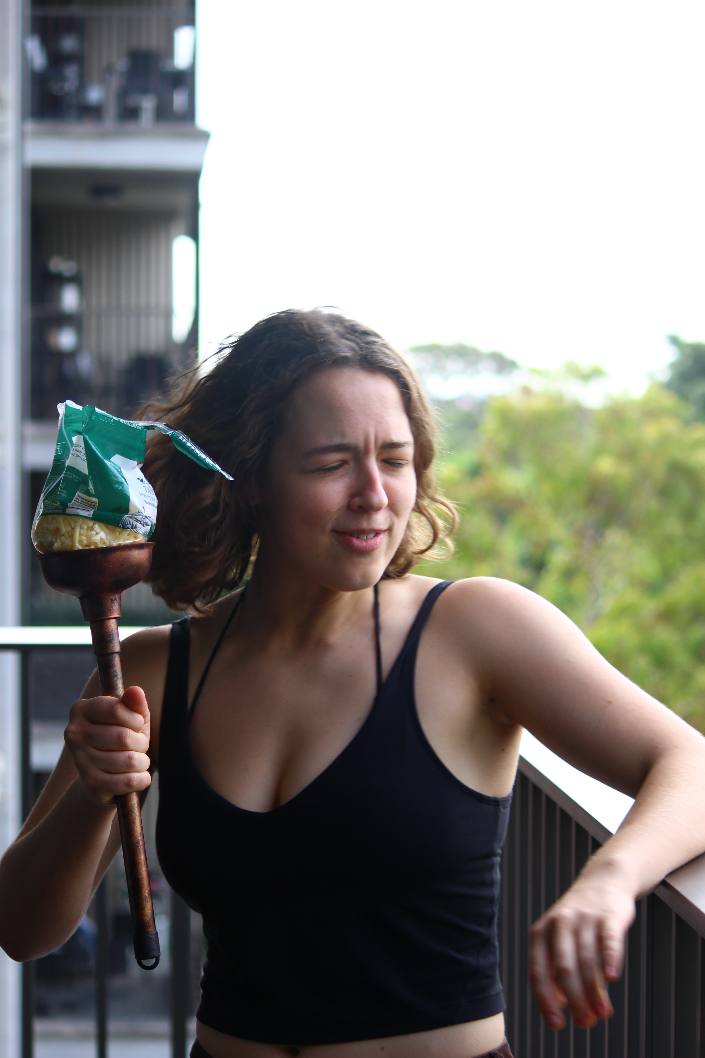
Photos/Aaron Camera Video/IMG_9374.JPG
