freesiagaul/Dalek/Photos/Aaron Camera Video/IMG_9375.JPG

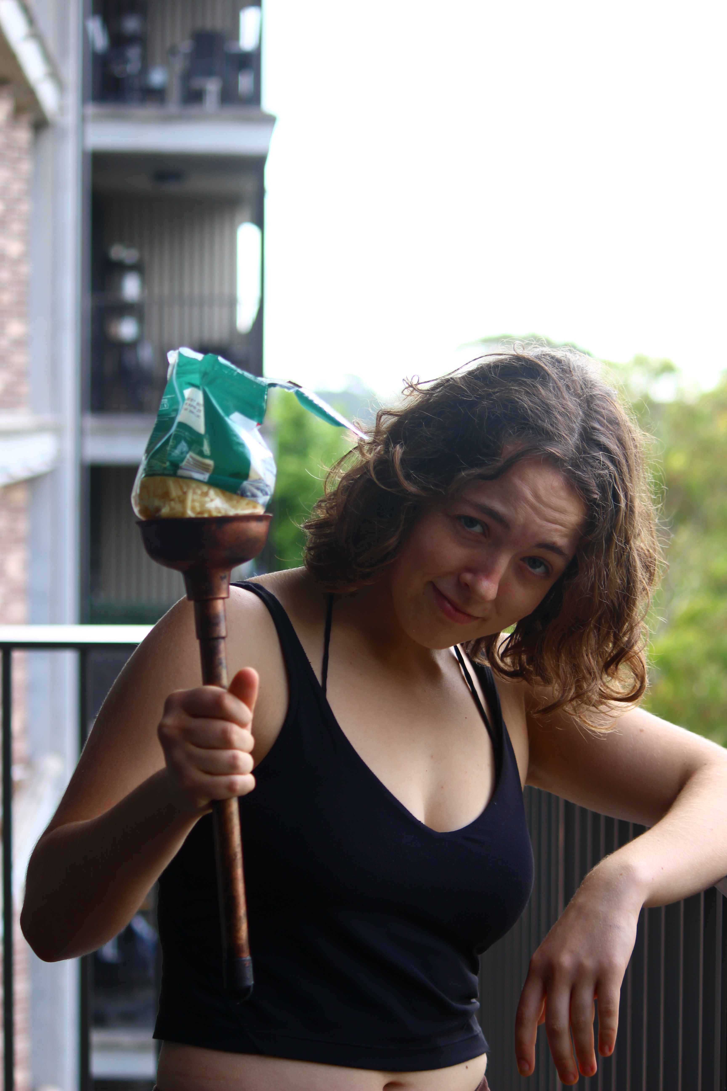
Photos/Aaron Camera Video/IMG_9375.JPG
