freesiagaul/Dalek/Photos/Aaron Camera Video/IMG_9377.JPG

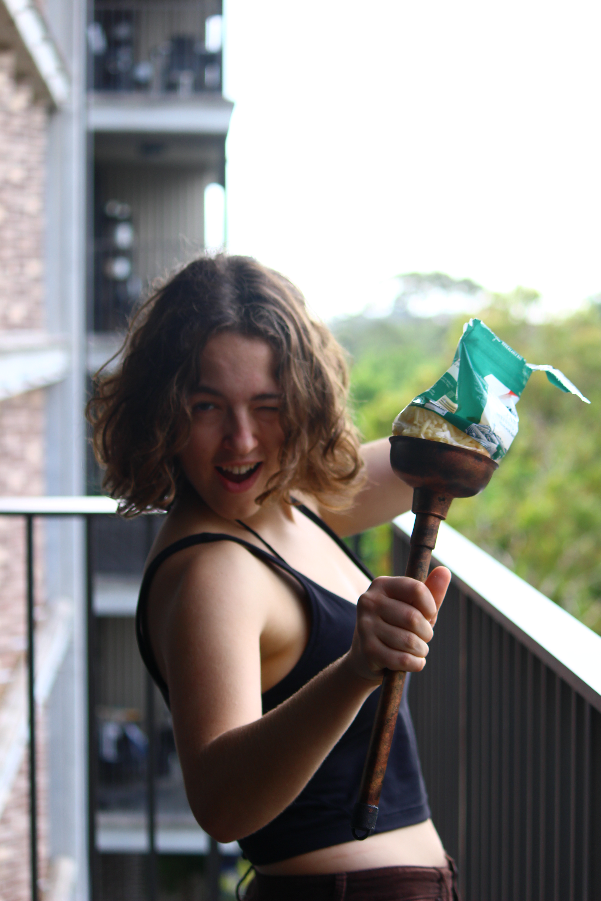
Photos/Aaron Camera Video/IMG_9377.JPG
