freesiagaul/Dalek/Photos/Aaron Camera Video/IMG_9378.JPG

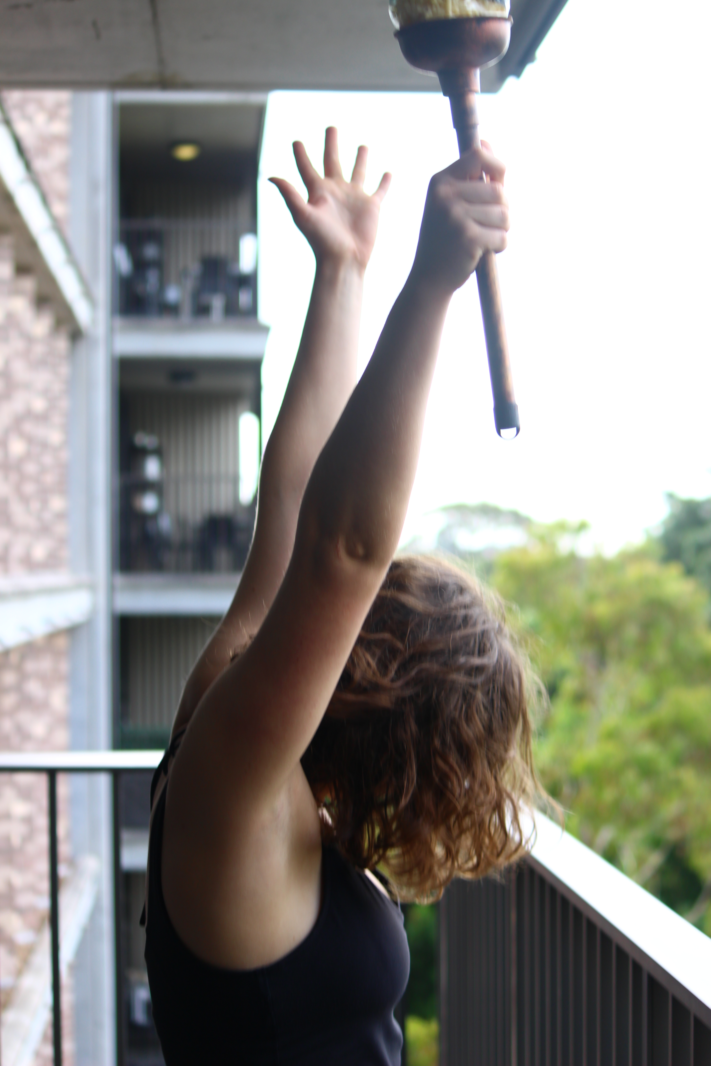
Photos/Aaron Camera Video/IMG_9378.JPG
