freesiagaul/Dalek/Photos/Aaron Camera Video/IMG_9379.JPG

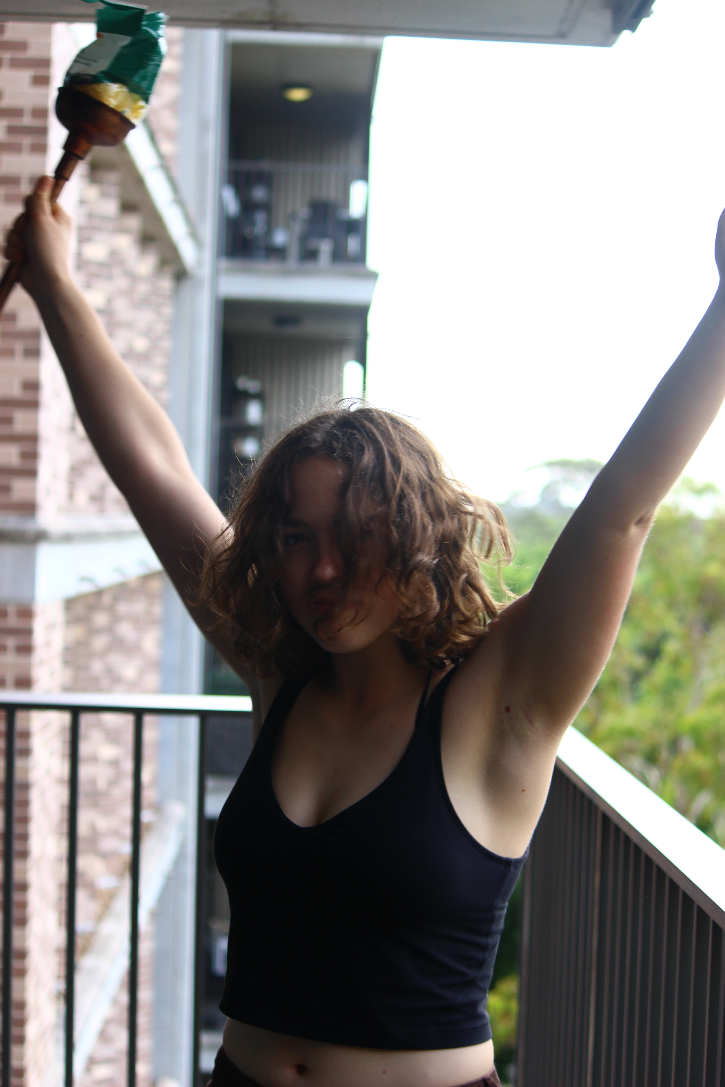
Photos/Aaron Camera Video/IMG_9379.JPG
