freesiagaul/Dalek/Photos/Aaron Camera Video/IMG_9380.JPG

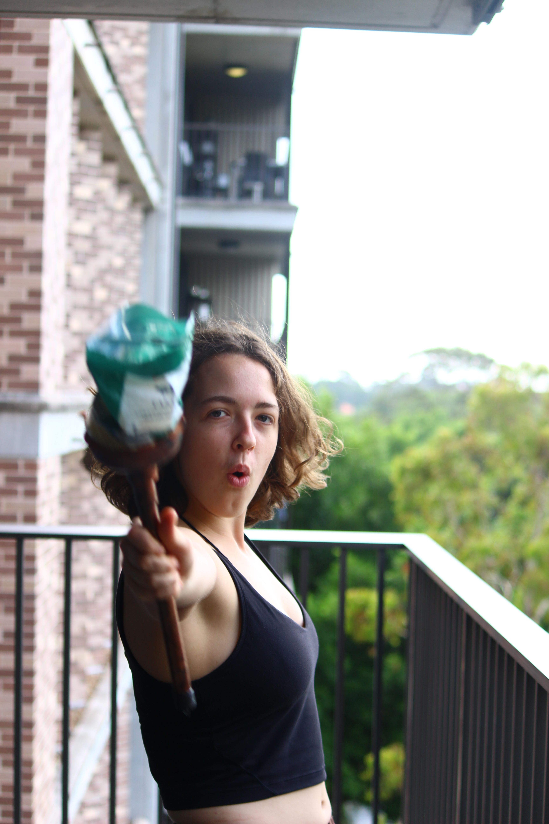
Photos/Aaron Camera Video/IMG_9380.JPG
