freesiagaul/Dalek/Photos/Aaron Camera Video/IMG_9382.JPG

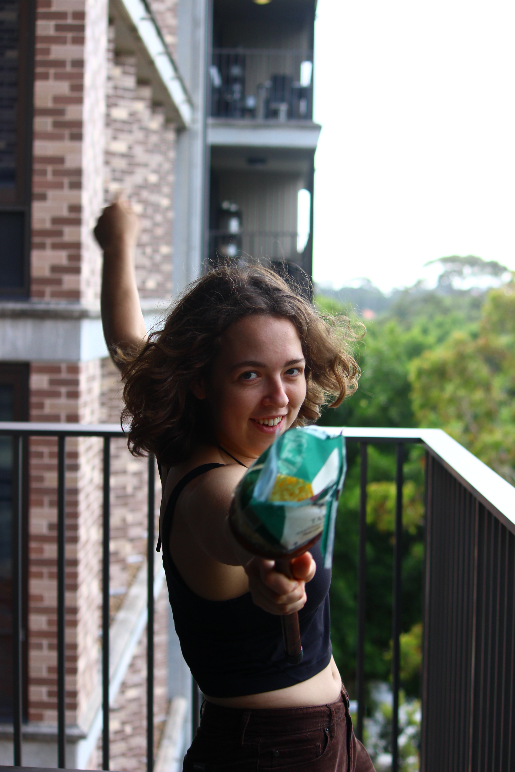
Photos/Aaron Camera Video/IMG_9382.JPG
