freesiagaul/Dalek/Photos/Aaron Camera Video/IMG_9383.JPG

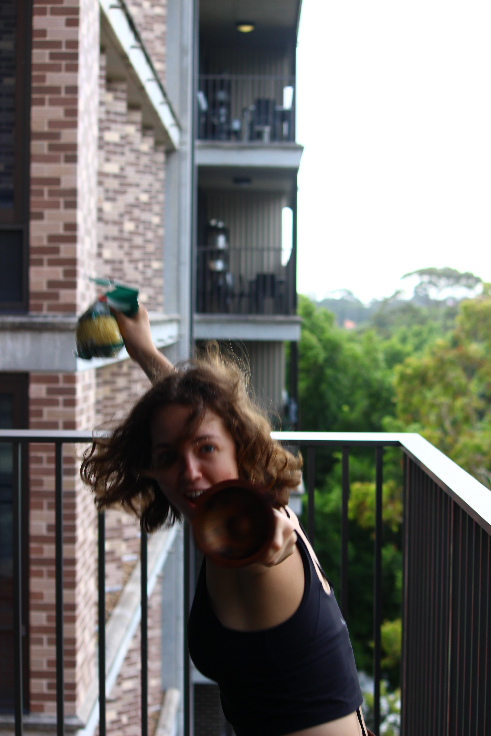
Photos/Aaron Camera Video/IMG_9383.JPG
