freesiagaul/Dalek/Photos/Aaron Camera Video/IMG_9403.JPG

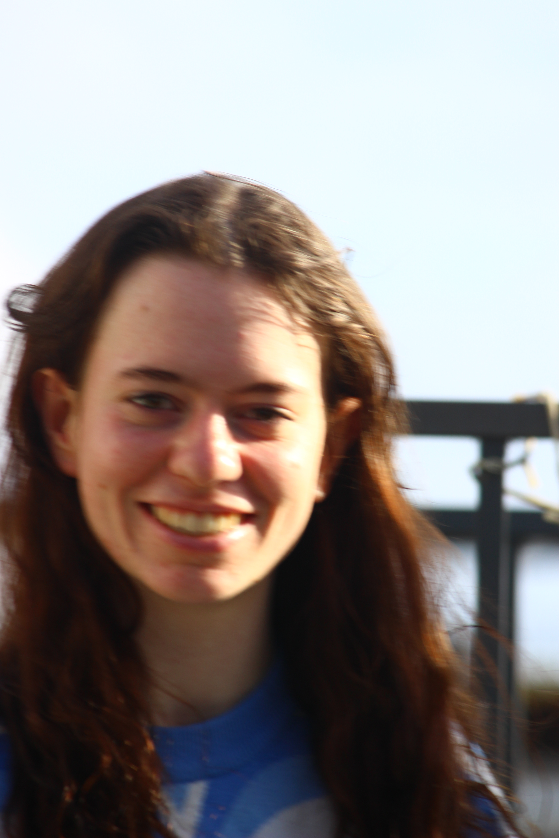
Photos/Aaron Camera Video/IMG_9403.JPG
