freesiagaul/Dalek/Photos/Aaron Camera Video/IMG_9405.JPG

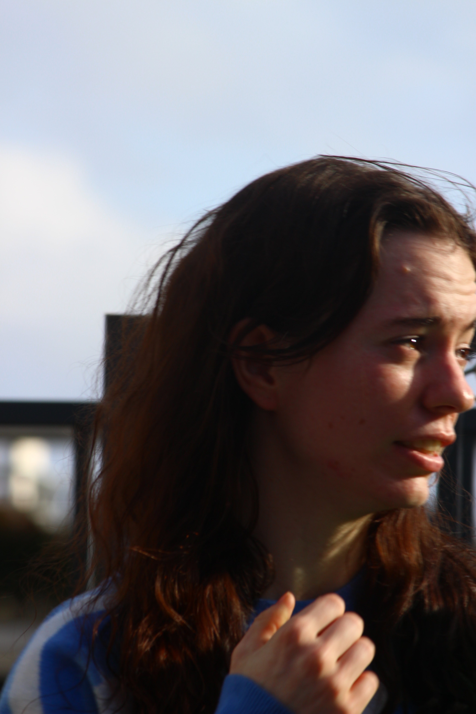
Photos/Aaron Camera Video/IMG_9405.JPG
