freesiagaul/Dalek/Photos/Aaron Camera Video/IMG_9406.JPG

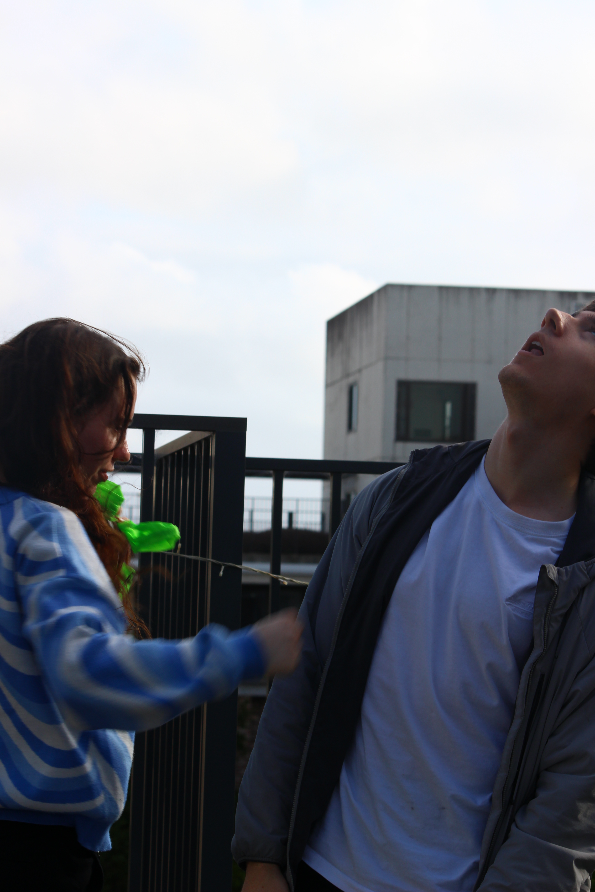
Photos/Aaron Camera Video/IMG_9406.JPG
