freesiagaul/Dalek/Photos/Aaron Camera Video/IMG_9409.JPG

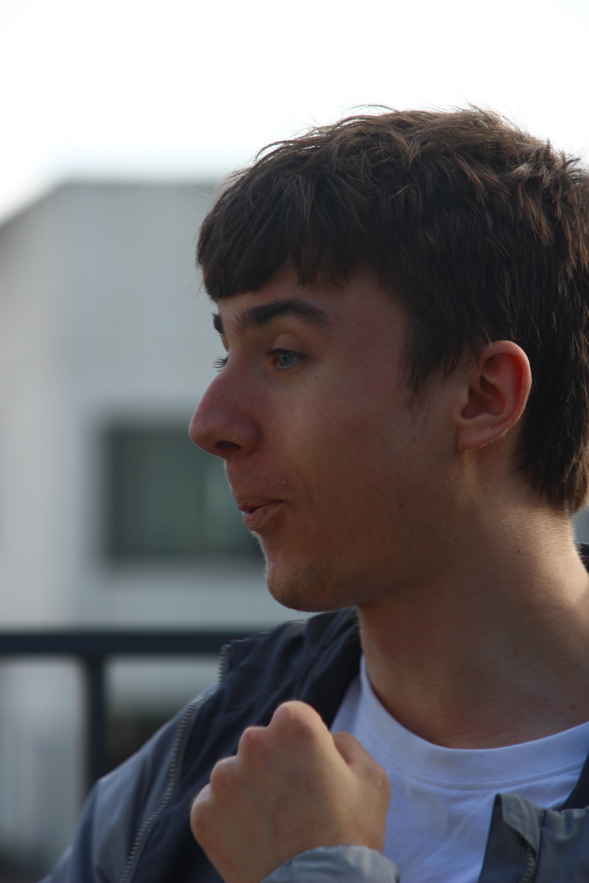
Photos/Aaron Camera Video/IMG_9409.JPG
