freesiagaul/Dalek/Photos/Aaron Camera Video/IMG_9410.JPG

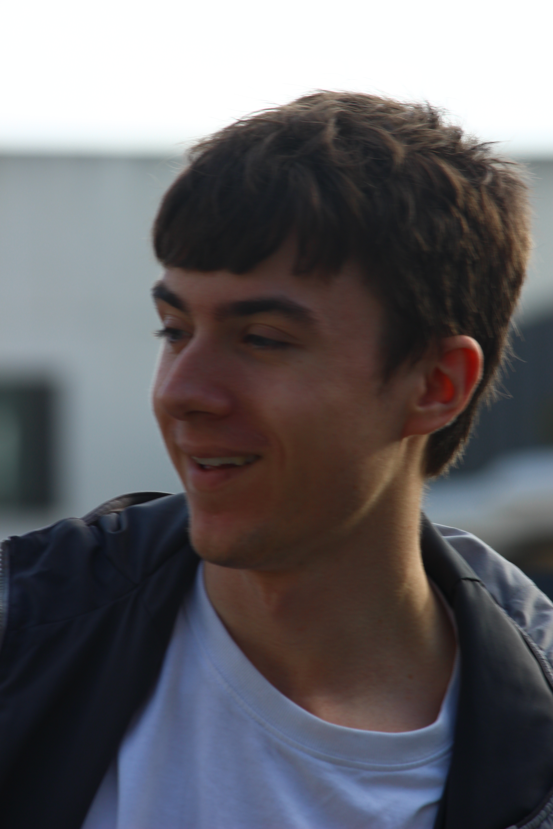
Photos/Aaron Camera Video/IMG_9410.JPG
