freesiagaul/Dalek/Photos/Aaron Camera Video/IMG_9411.JPG

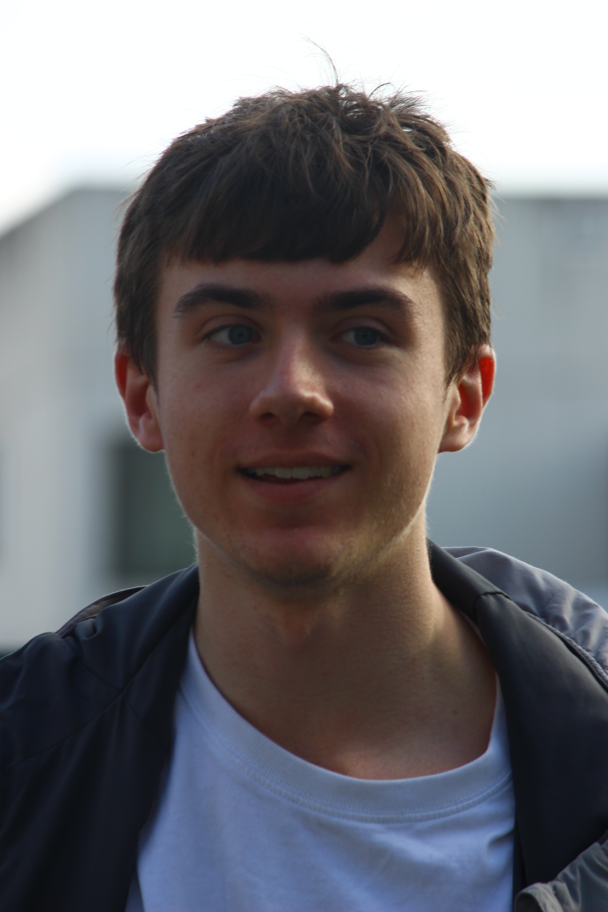
Photos/Aaron Camera Video/IMG_9411.JPG
