freesiagaul/Dalek/Photos/Aaron Camera Video/IMG_9413.JPG

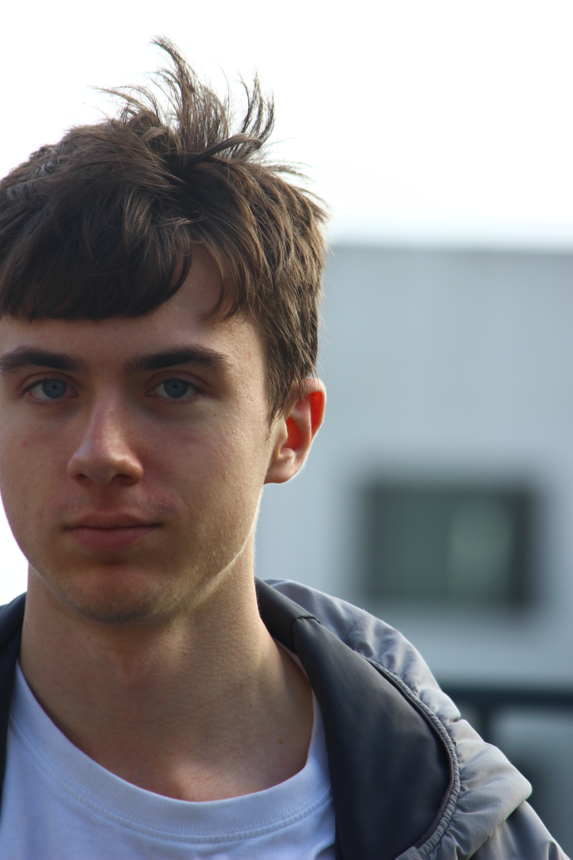
Photos/Aaron Camera Video/IMG_9413.JPG
