freesiagaul/Dalek/Photos/Aaron Camera Video/IMG_9497.JPG

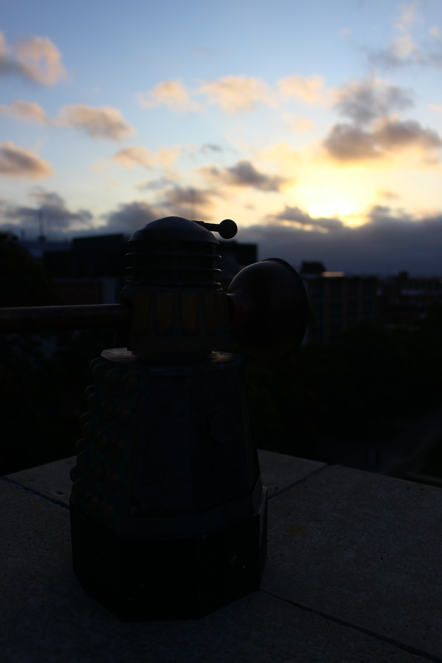
Photos/Aaron Camera Video/IMG_9497.JPG
