freesiagaul/Dalek/Photos/Aaron Camera Video/IMG_9498.JPG

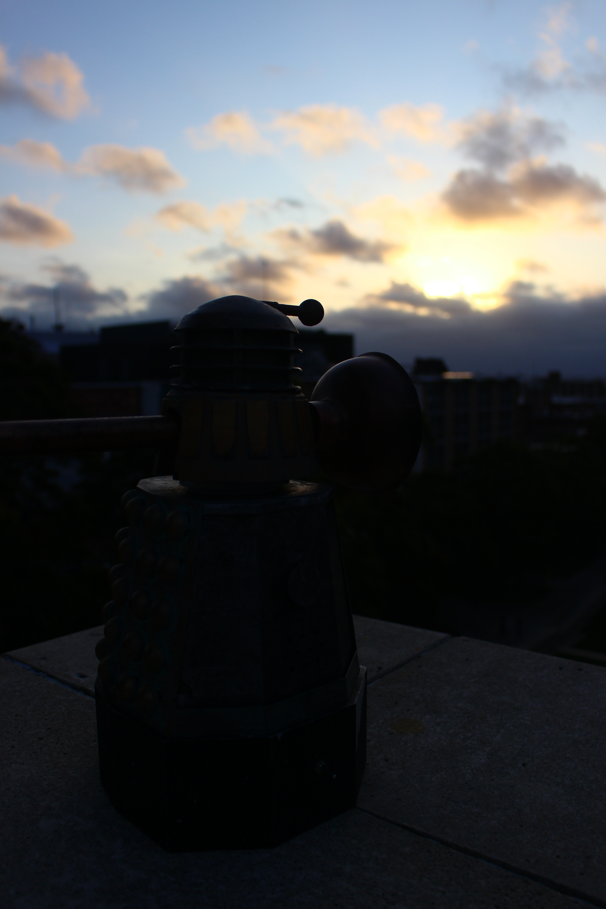
Photos/Aaron Camera Video/IMG_9498.JPG
