freesiagaul/Dalek/Photos/Aaron Camera Video/IMG_9499.JPG

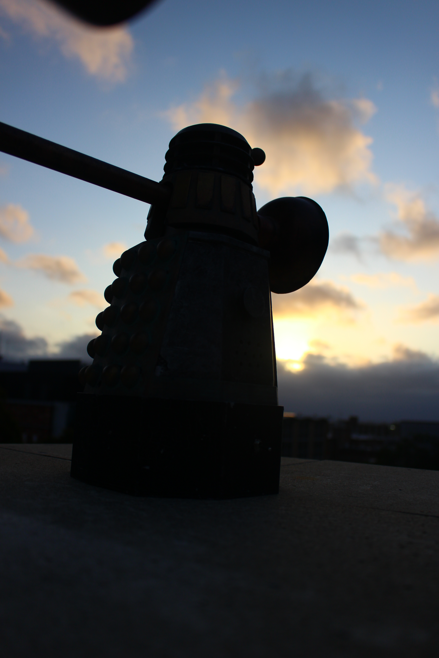
Photos/Aaron Camera Video/IMG_9499.JPG
