freesiagaul/Dalek/Photos/Aaron Camera Video/IMG_9500.JPG

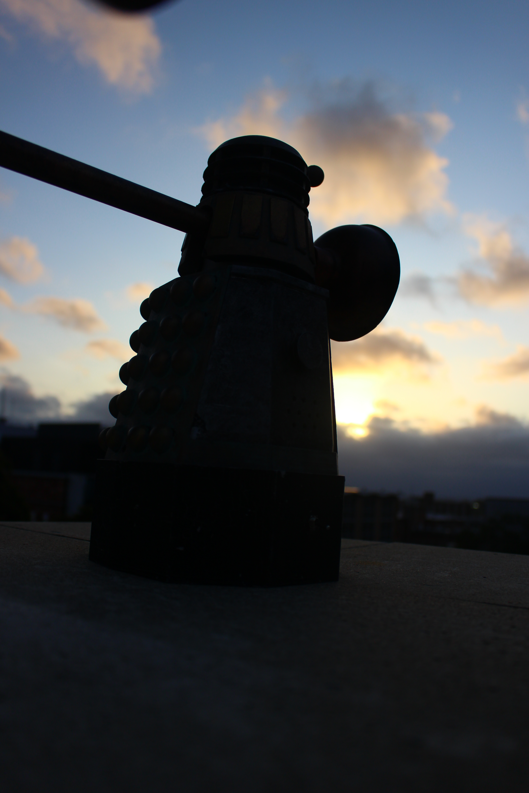
Photos/Aaron Camera Video/IMG_9500.JPG
