freesiagaul/Dalek/Photos/Aaron Camera Video/IMG_9502.JPG

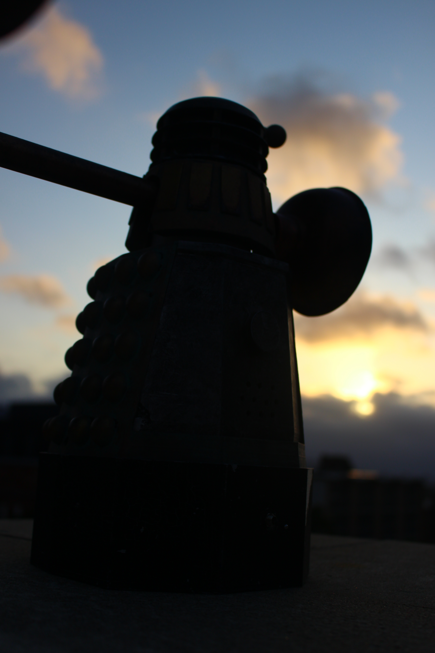
Photos/Aaron Camera Video/IMG_9502.JPG
