freesiagaul/Dalek/Photos/Aaron Camera Video/IMG_9506.JPG

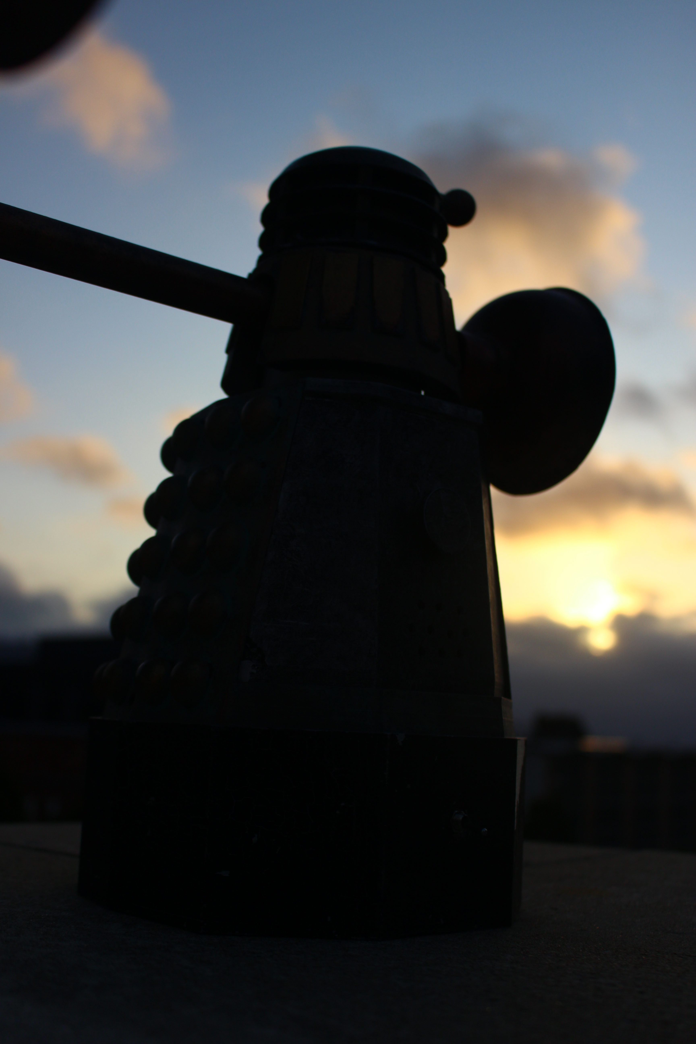
Photos/Aaron Camera Video/IMG_9506.JPG
