freesiagaul/Dalek/Photos/Aaron Camera Video/IMG_9507.JPG

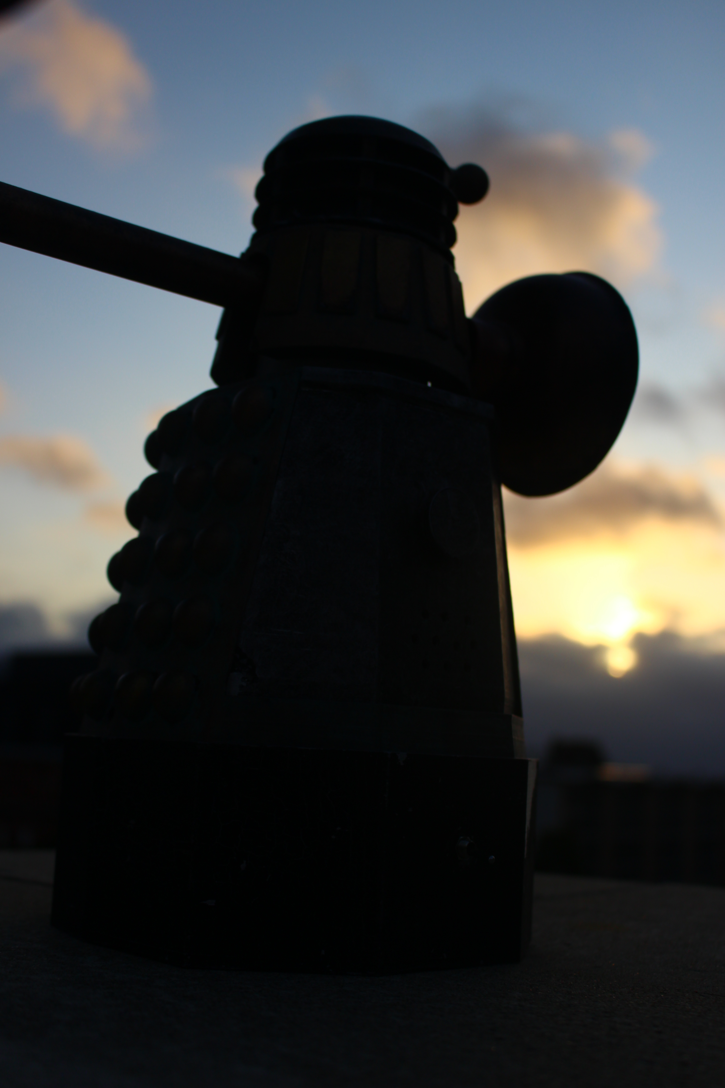
Photos/Aaron Camera Video/IMG_9507.JPG
