freesiagaul/Dalek/Photos/Aaron General/IMG_8076.JPG

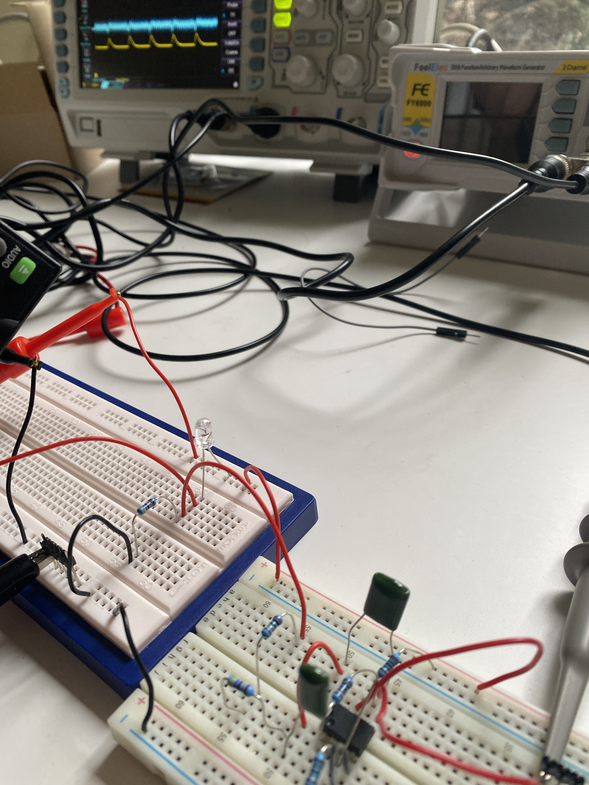
Photos/Aaron General/IMG_8076.JPG
