freesiagaul/Dalek/Photos/Aaron General/IMG_8077.JPG

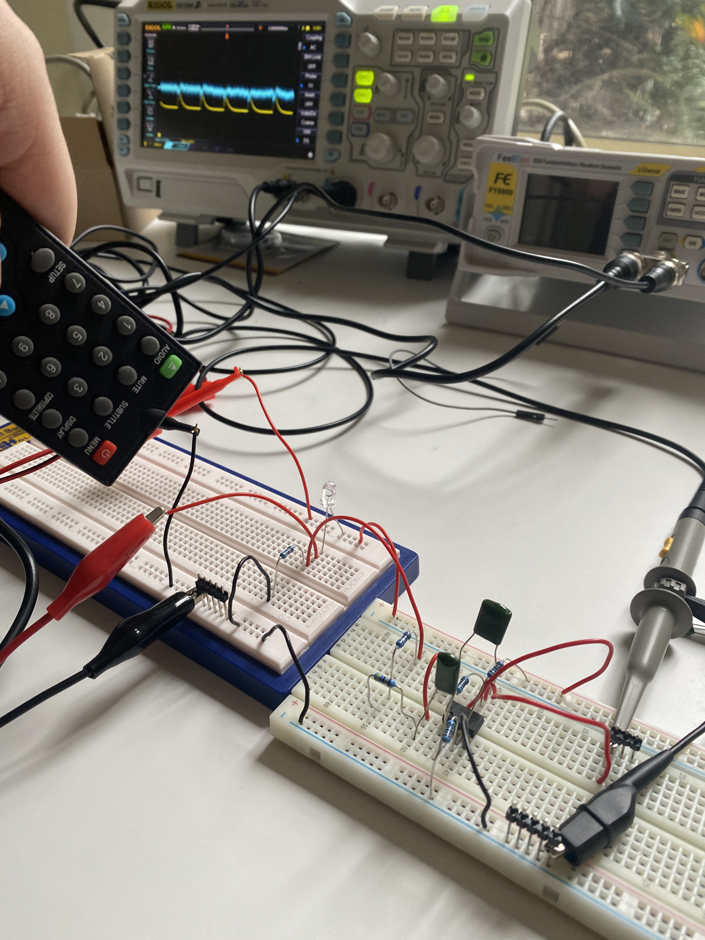
Photos/Aaron General/IMG_8077.JPG
