freesiagaul/Dalek/Photos/Aaron General/IMG_8183.JPG

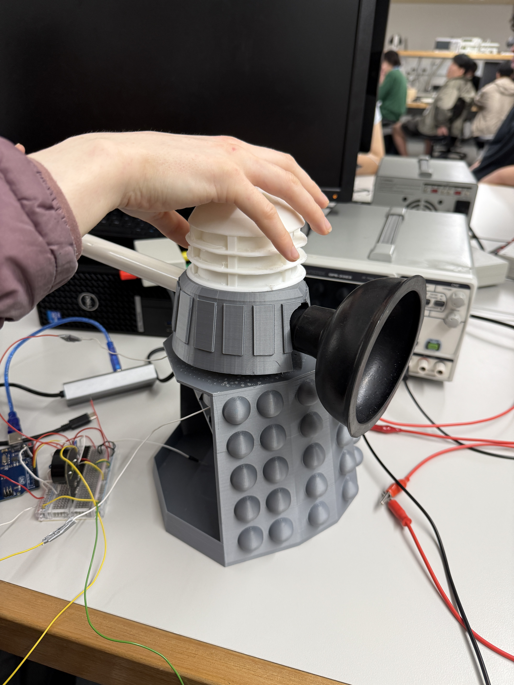
Photos/Aaron General/IMG_8183.JPG
