freesiagaul/Dalek/Photos/Aaron General/IMG_8184.JPG

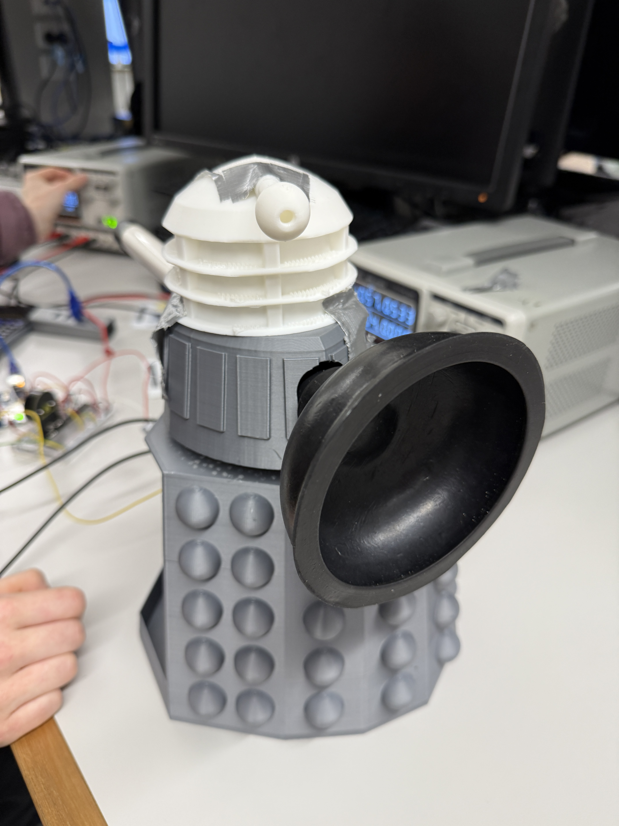
Photos/Aaron General/IMG_8184.JPG
