freesiagaul/Dalek/Photos/Aaron General/IMG_8185.JPG

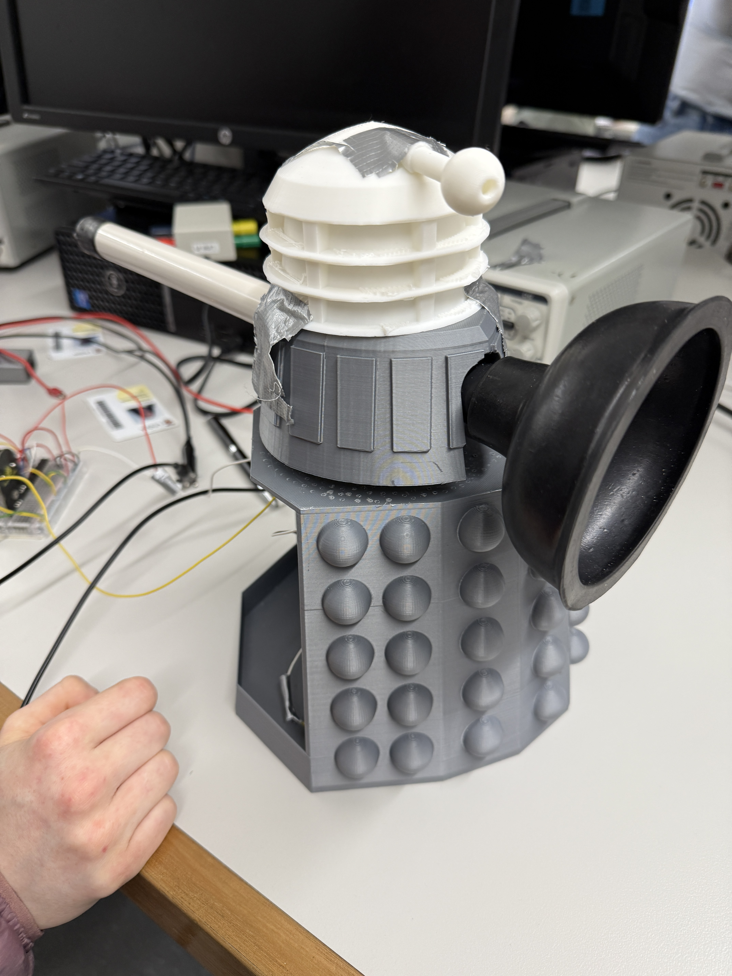
Photos/Aaron General/IMG_8185.JPG
