freesiagaul/Dalek/Photos/Aaron General/IMG_8204.JPG

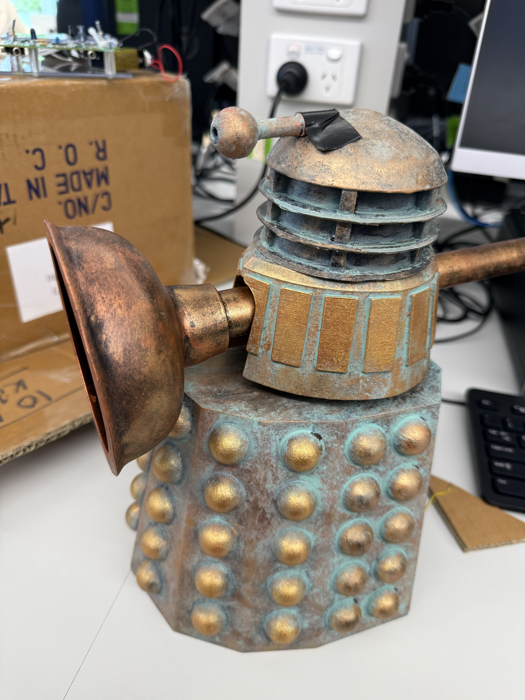
Photos/Aaron General/IMG_8204.JPG
