freesiagaul/Dalek/Photos/Aaron General/IMG_8207 2.JPG

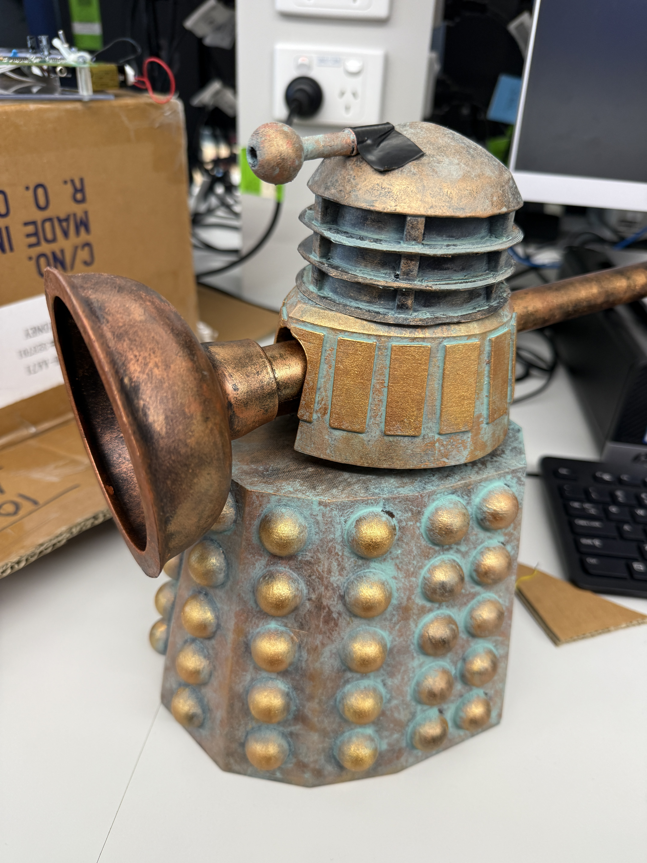
Photos/Aaron General/IMG_8207 2.JPG
