freesiagaul/Dalek/Photos/Aaron General/IMG_8392.JPG

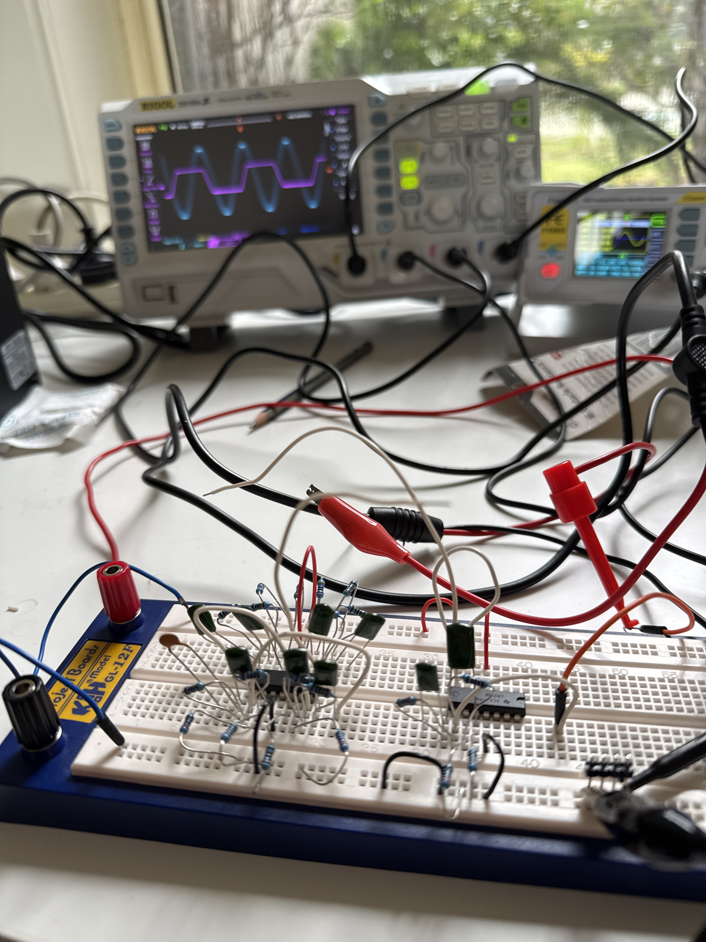
Photos/Aaron General/IMG_8392.JPG
