freesiagaul/Dalek/Photos/Aaron General/IMG_8396.JPG

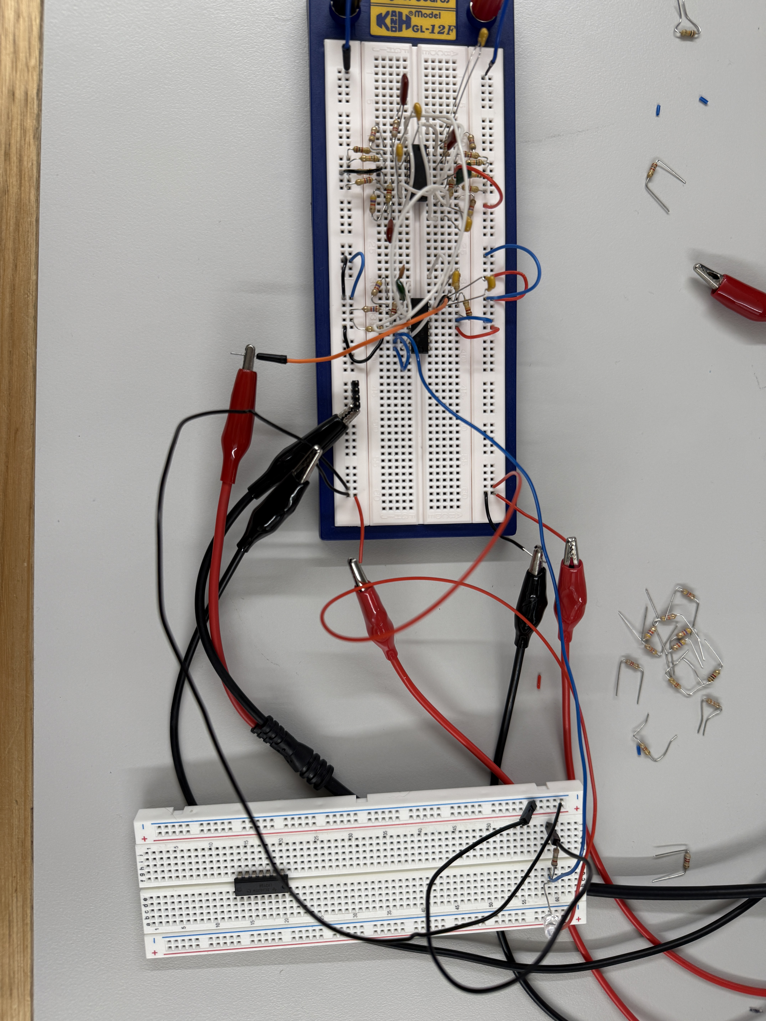
Photos/Aaron General/IMG_8396.JPG
