freesiagaul/Dalek/Photos/Aaron General/IMG_8397.JPG

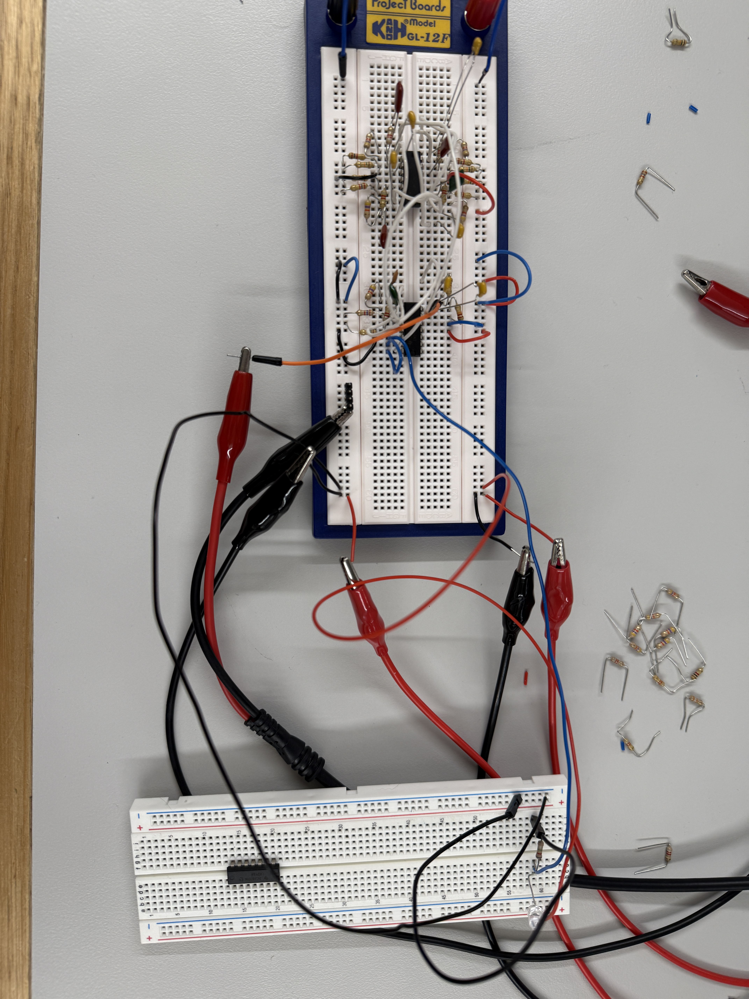
Photos/Aaron General/IMG_8397.JPG
