freesiagaul/Dalek/Photos/Aaron General/IMG_8182.JPG

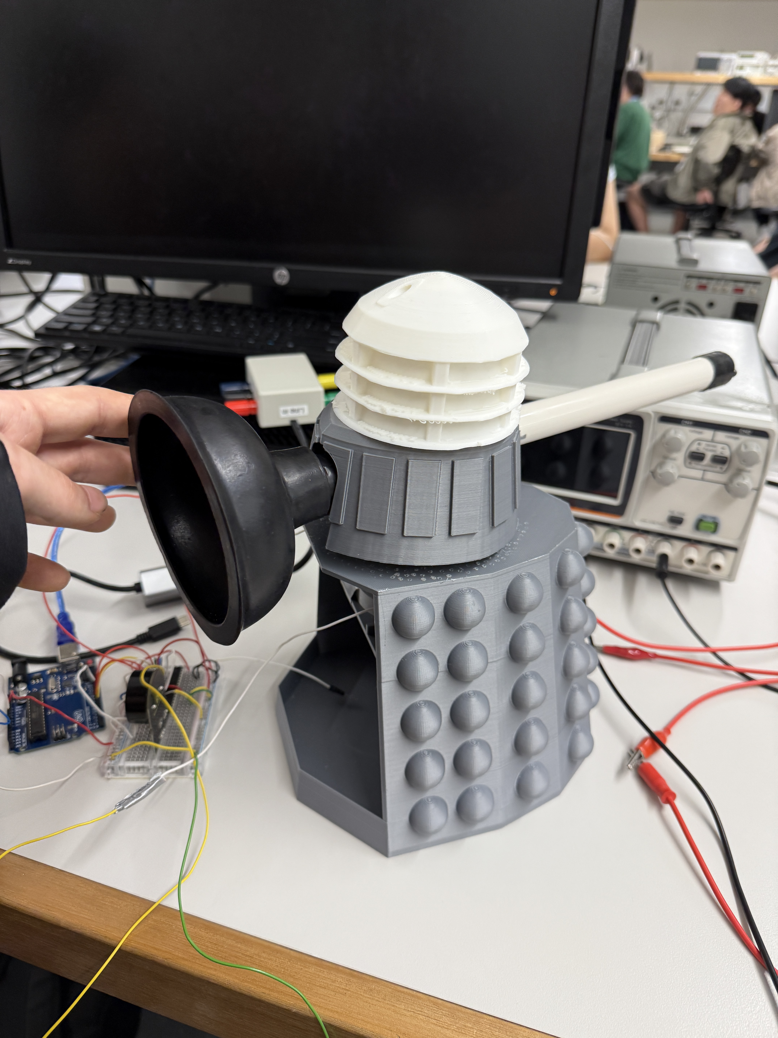
Photos/Aaron General/IMG_8182.JPG
